omarmustafa130/Custom-ESP-Controller/Zrzut ekranu 2025-04-6 o 13.15.30.png

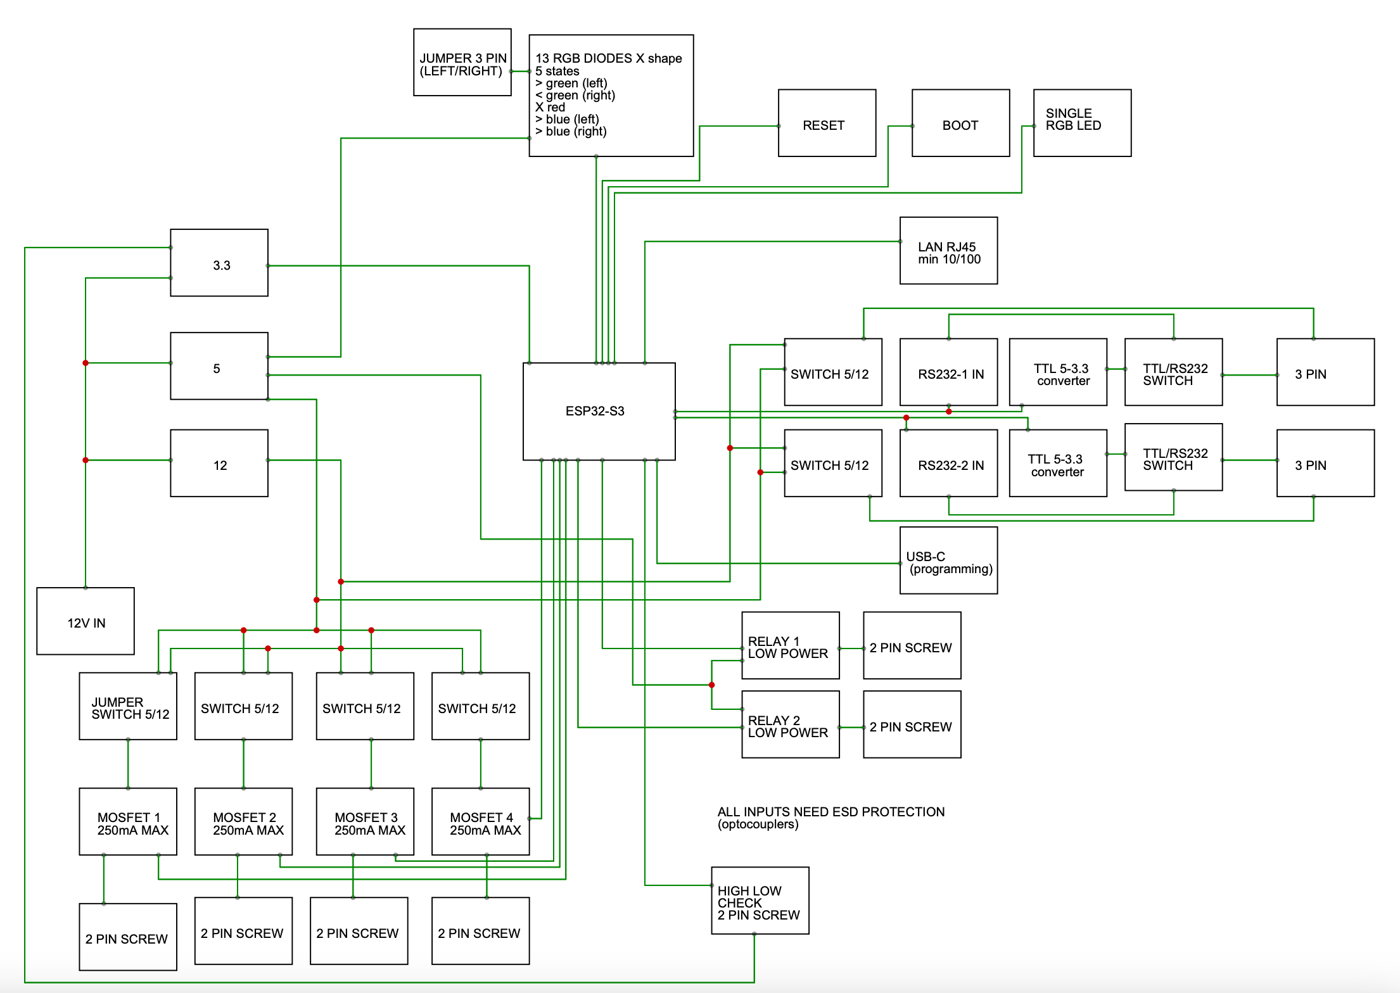
Zrzut ekranu 2025-04-6 o 13.15.30.png
