omarmustafa130/Custom-ESP-Controller/Symbols, footprints, & 3d parts/ETHERNET/LIB_HSO321S/HSO321S/3D/HSO321S.stp

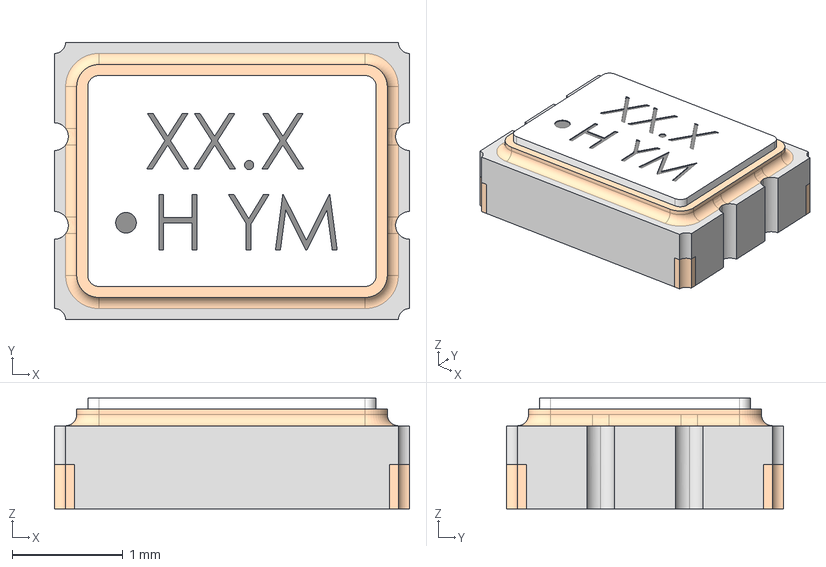
[picture p2: CAD file, 2025-05-19]
Symbols, footprints, & 3d parts/ETHERNET/LIB_HSO321S/HSO321S/3D/HSO321S.stp
3.20 x 2.50 x 1.00 mm
SSW024576F3CHC-T
SSW024576F3CHC-T003
SSW024576F3CHC-T004
SSW024576F3CHC-T002
SSW024576F3CHC-T001
