omarmustafa130/Custom-ESP-Controller/Symbols, footprints, & 3d parts/ETHERNET/LIB_W5500/W5500/3D/W5500.stp

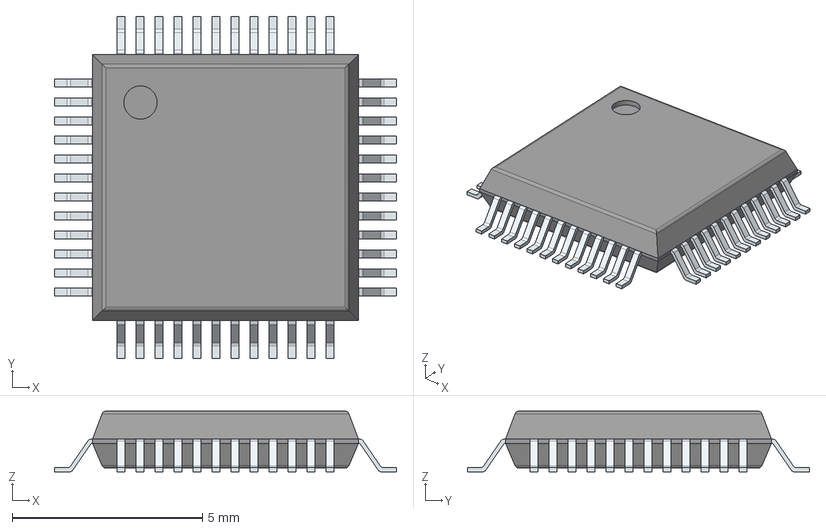
[picture p3: CAD file, 2025-05-19]
Symbols, footprints, & 3d parts/ETHERNET/LIB_W5500/W5500/3D/W5500.stp
9.00 x 9.00 x 1.60 mm
PinsArrayLR
PinsArrayTB
