omarmustafa130/Custom-ESP-Controller/Symbols, footprints, & 3d parts/ETHERNET/RJ45_163141781-659-5-2301994-9/5-2301994-9.stp

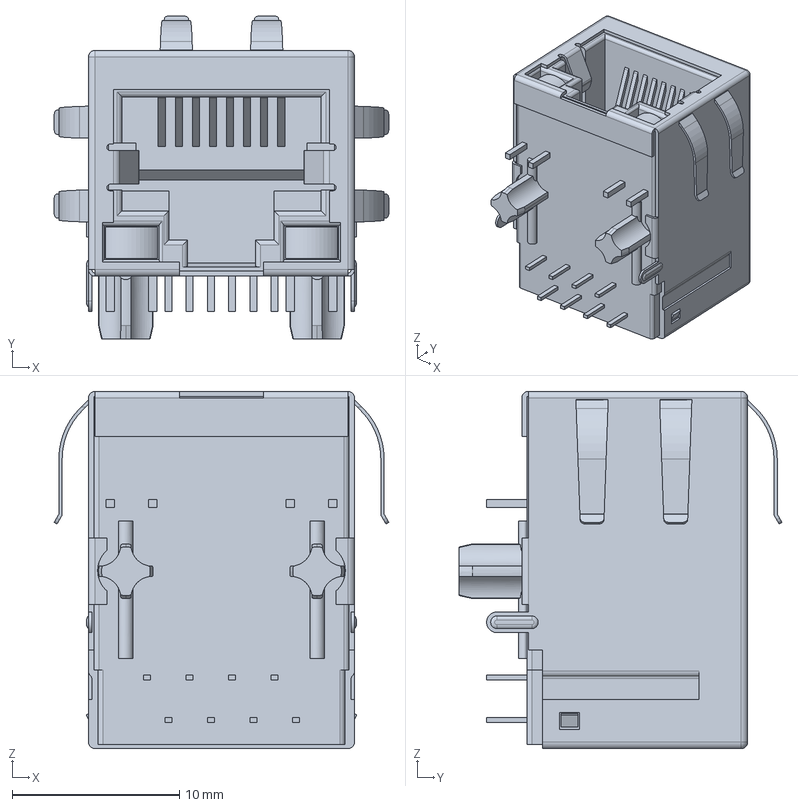
[picture p4: CAD file, 2025-05-19]
Symbols, footprints, & 3d parts/ETHERNET/RJ45_163141781-659-5-2301994-9/5-2301994-9.stp
20.0 x 19.3 x 21.4 mm
