omarmustafa130/Custom-ESP-Controller/Symbols, footprints, & 3d parts/LIB_ECS-3225MVQ-400-BS-TR/ECS-3225MVQ-400-BS-TR/3D/ECS-3225MVQ-400-BS-TR.stp

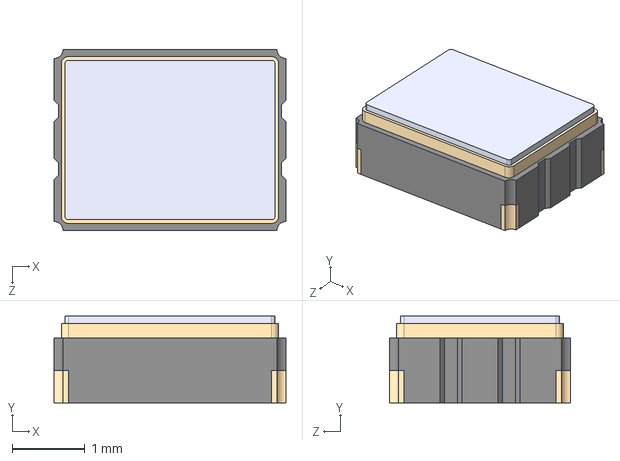
[picture p5: CAD file, 2025-05-18]
Symbols, footprints, & 3d parts/LIB_ECS-3225MVQ-400-BS-TR/ECS-3225MVQ-400-BS-TR/3D/ECS-3225MVQ-400-BS-TR.stp
3.20 x 1.20 x 2.50 mm
