omarmustafa130/Custom-ESP-Controller/Symbols, footprints, & 3d parts/LIB_ESP32-C6/ESP32-C6/3D/ESP32-C6.stp

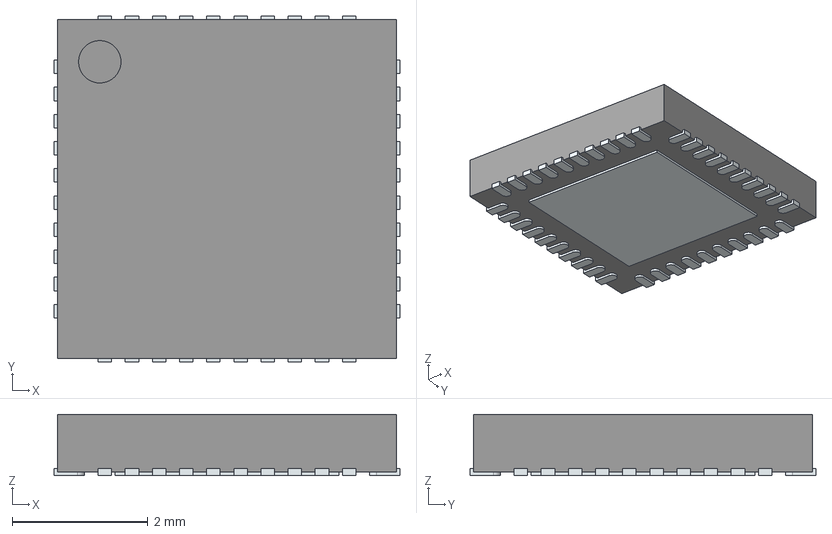
[picture p6: CAD file, 2025-05-18]
Symbols, footprints, & 3d parts/LIB_ESP32-C6/ESP32-C6/3D/ESP32-C6.stp
5.10 x 5.10 x 0.9 mm
ThermalPin
PinsArrayLR
PinsArrayTB
