omarmustafa130/Custom-ESP-Controller/Symbols, footprints, & 3d parts/LIB_ESP32-D0WDQ6/ESP32-D0WDQ6/3D/ESP32-D0WDQ6.stp

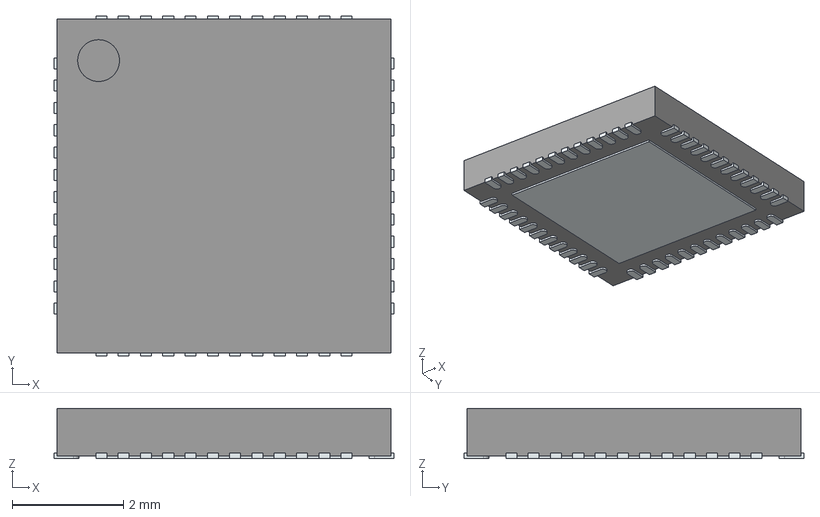
[picture p7: CAD file, 2025-05-18]
Symbols, footprints, & 3d parts/LIB_ESP32-D0WDQ6/ESP32-D0WDQ6/3D/ESP32-D0WDQ6.stp
6.10 x 6.10 x 0.9 mm
ThermalPin
PinsArrayLR
PinsArrayTB
