omarmustafa130/Custom-ESP-Controller/Symbols, footprints, & 3d parts/LIB_ESP32-S3/ESP32-S3/3D/ESP32-S3.stp

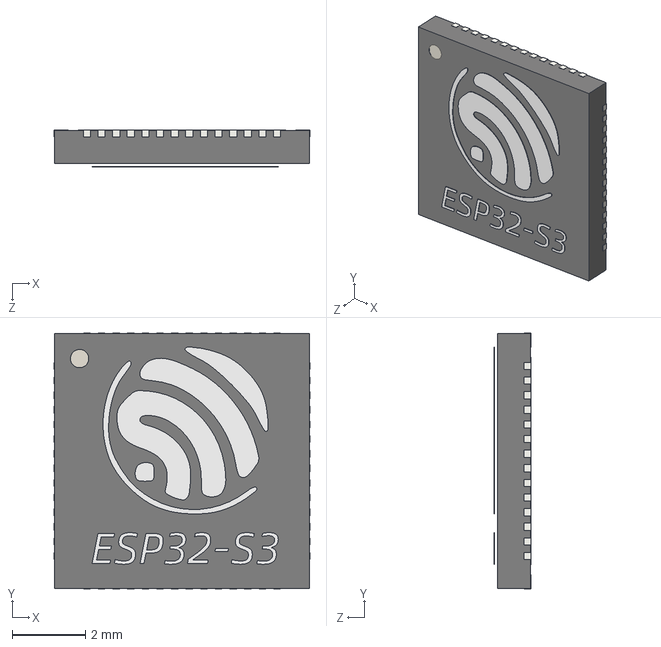
[picture p8: CAD file, 2025-05-18]
Symbols, footprints, & 3d parts/LIB_ESP32-S3/ESP32-S3/3D/ESP32-S3.stp
7.00 x 7.00 x 1.02 mm
