omarmustafa130/Custom-ESP-Controller/Symbols, footprints, & 3d parts/LIB_H1102NLT/H1102NLT/3D/H1102NLT.stp

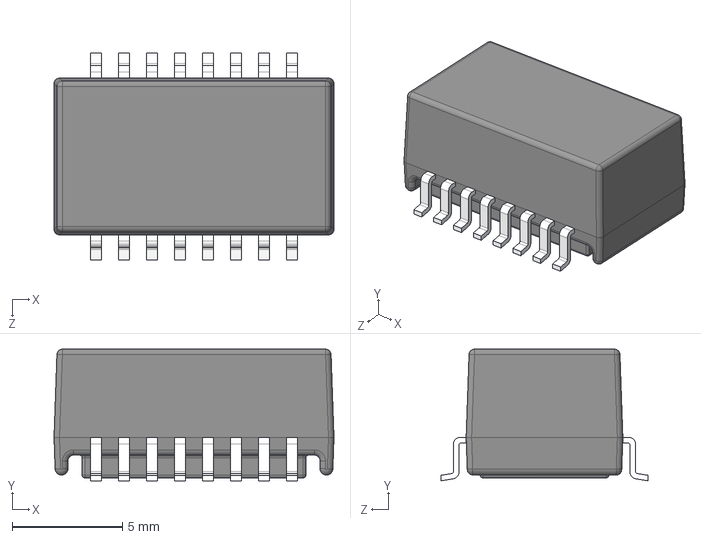
[picture p9: CAD file, 2025-05-18]
Symbols, footprints, & 3d parts/LIB_H1102NLT/H1102NLT/3D/H1102NLT.stp
12.7 x 5.97 x 9.40 mm
