omarmustafa130/Custom-ESP-Controller/Symbols, footprints, & 3d parts/LIB_J1B1211CCD/J1B1211CCD/3D/J1B1211CCD.stp

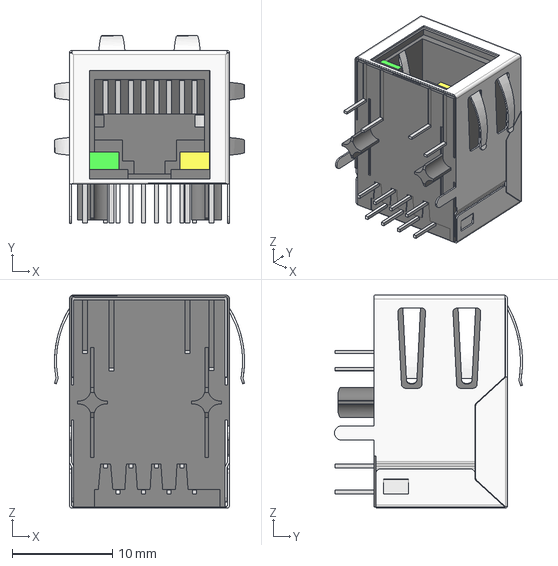
[picture p10: CAD file, 2025-05-18]
Symbols, footprints, & 3d parts/LIB_J1B1211CCD/J1B1211CCD/3D/J1B1211CCD.stp
19.0 x 18.8 x 21.3 mm
