omarmustafa130/Custom-ESP-Controller/Symbols, footprints, & 3d parts/MOSFETS/LIB_IRLML6244TRPBF/IRLML6244TRPBF/3D/IRLML6244TRPBF.stp

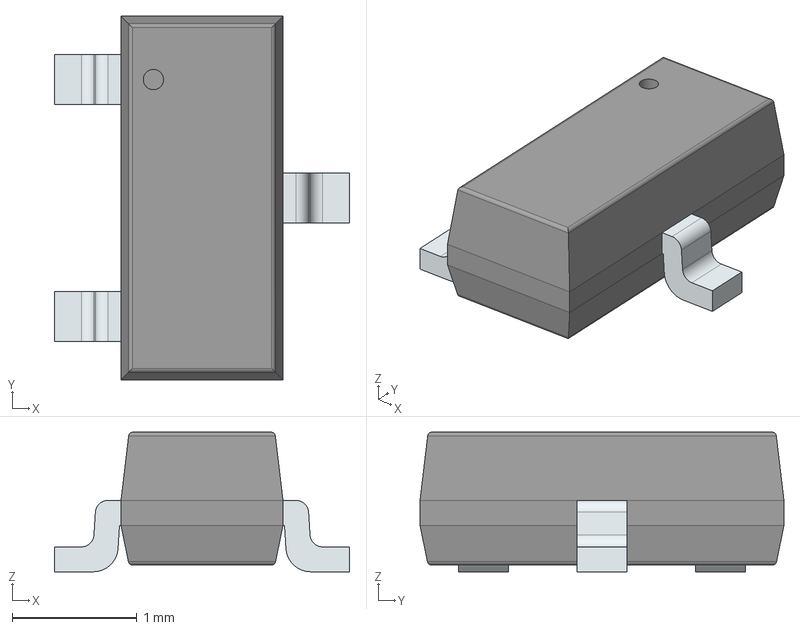
[picture p11: CAD file, 2025-05-19]
Symbols, footprints, & 3d parts/MOSFETS/LIB_IRLML6244TRPBF/IRLML6244TRPBF/3D/IRLML6244TRPBF.stp
2.37 x 2.92 x 1.12 mm
PinsArrayL
FilletPinR
