omarmustafa130/Custom-ESP-Controller/Symbols, footprints, & 3d parts/Power Circuit/LIB_1N5822/1N5822/3D/1N5822.stp

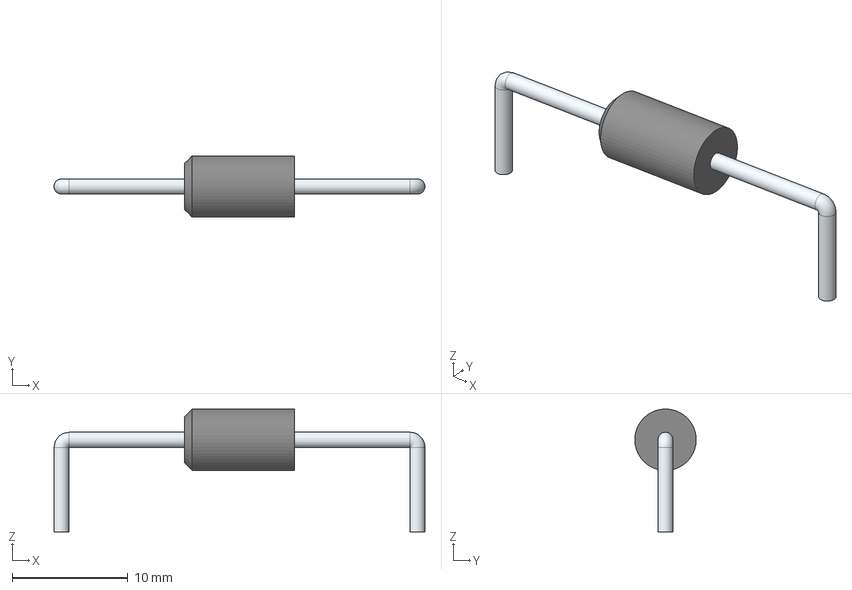
[picture p12: CAD file, 2025-05-19]
Symbols, footprints, & 3d parts/Power Circuit/LIB_1N5822/1N5822/3D/1N5822.stp
32.0 x 5.30 x 10.6 mm
