omarmustafa130/Custom-ESP-Controller/Symbols, footprints, & 3d parts/Power Circuit/LIB_SMAJ58A/SMAJ58A/3D/SMAJ58A.stp

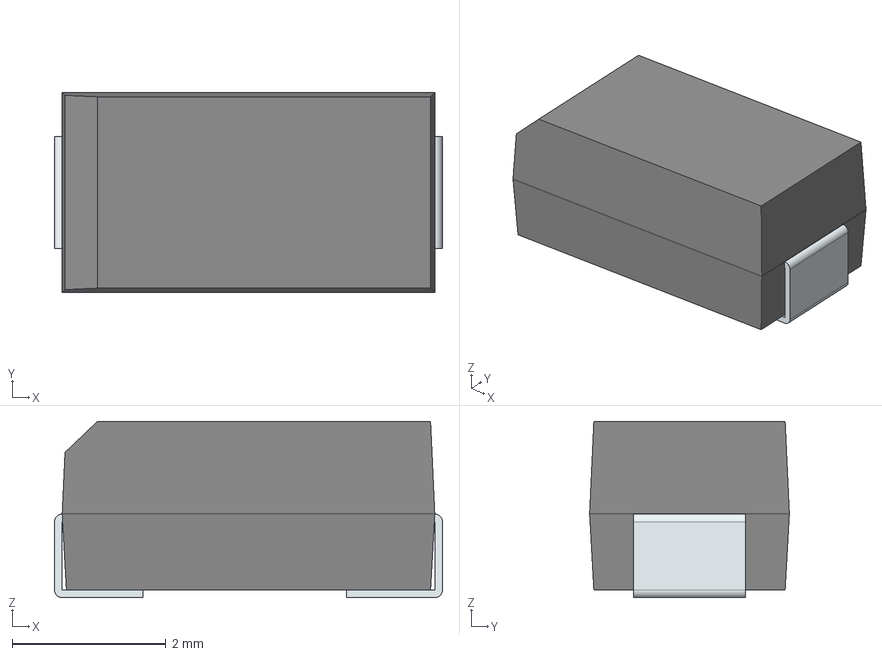
[picture p13: CAD file, 2025-05-19]
Symbols, footprints, & 3d parts/Power Circuit/LIB_SMAJ58A/SMAJ58A/3D/SMAJ58A.stp
5.04 x 2.60 x 2.29 mm
FilletPin1
FilletPin2
