omarmustafa130/Custom-ESP-Controller/Symbols, footprints, & 3d parts/Power Circuit/LIB_SMD_IC_SY8089AAAC/SMD_IC_SY8089AAAC/3D/SMD_IC_SY8089AAAC.stp

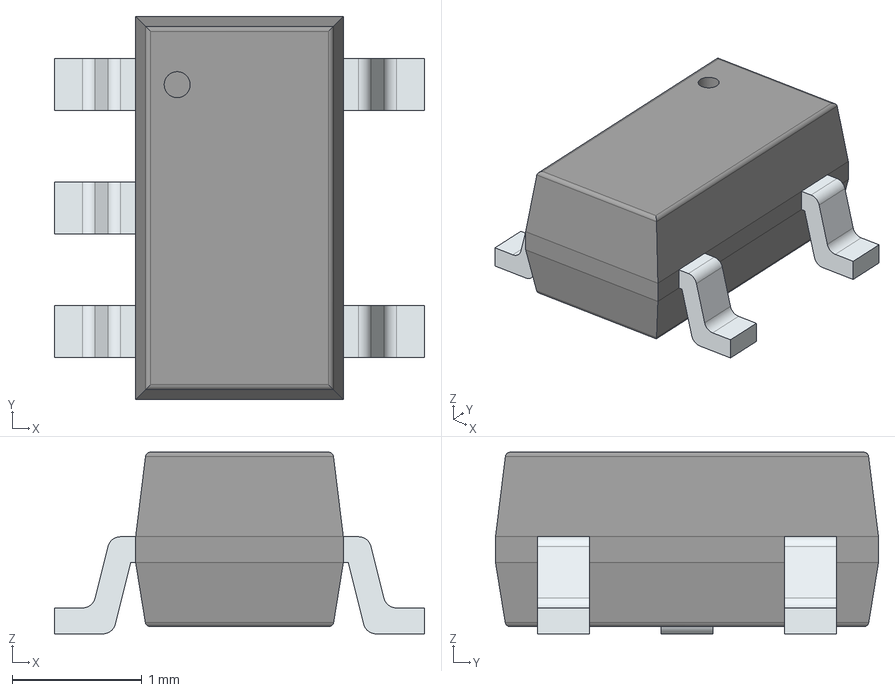
[picture p14: CAD file, 2025-05-18]
Symbols, footprints, & 3d parts/Power Circuit/LIB_SMD_IC_SY8089AAAC/SMD_IC_SY8089AAAC/3D/SMD_IC_SY8089AAAC.stp
2.85 x 2.95 x 1.40 mm
PinsArrayL
PinsArrayR
