omarmustafa130/Custom-ESP-Controller/Symbols, footprints, & 3d parts/Power Circuit/LIB_TX4138/TX4138/3D/TX4138.stp

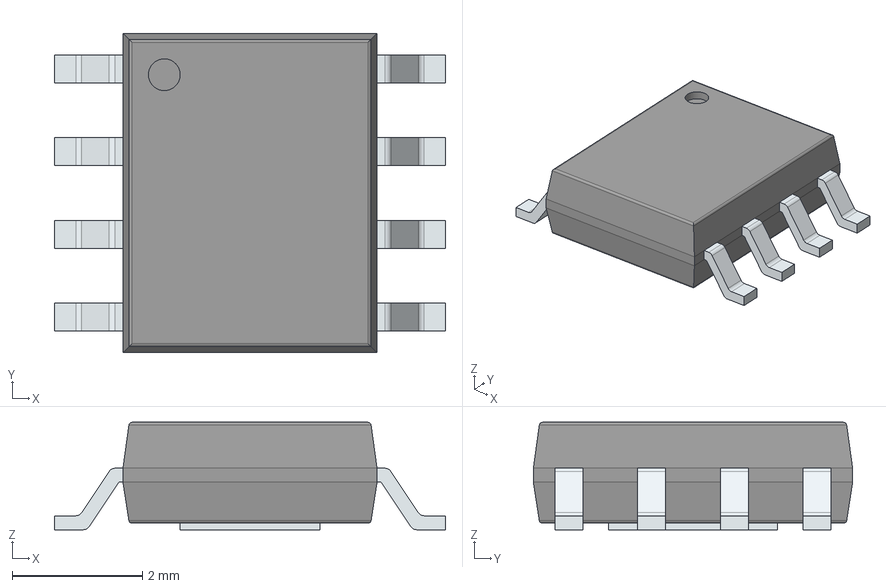
[picture p15: CAD file, 2025-05-19]
Symbols, footprints, & 3d parts/Power Circuit/LIB_TX4138/TX4138/3D/TX4138.stp
6.00 x 4.90 x 1.65 mm
PinsArrayLR
ThermalPad
