omarmustafa130/Custom-ESP-Controller/Symbols, footprints, & 3d parts/Power Circuit/NR3015T2R2M/NR3015T2R2M.step

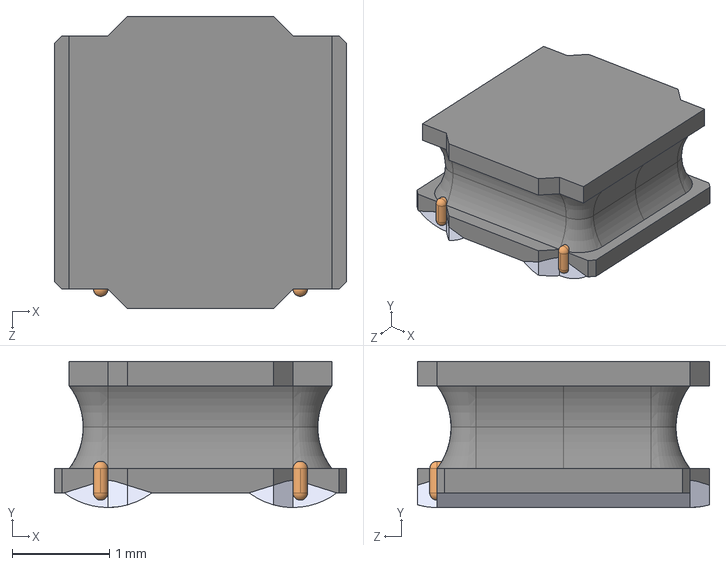
[picture p16: CAD file, 2025-05-19]
Symbols, footprints, & 3d parts/Power Circuit/NR3015T2R2M/NR3015T2R2M.step
3.00 x 1.50 x 3.00 mm
