omarmustafa130/Custom-ESP-Controller/Symbols, footprints, & 3d parts/Power Circuit/SS310/SS310.step

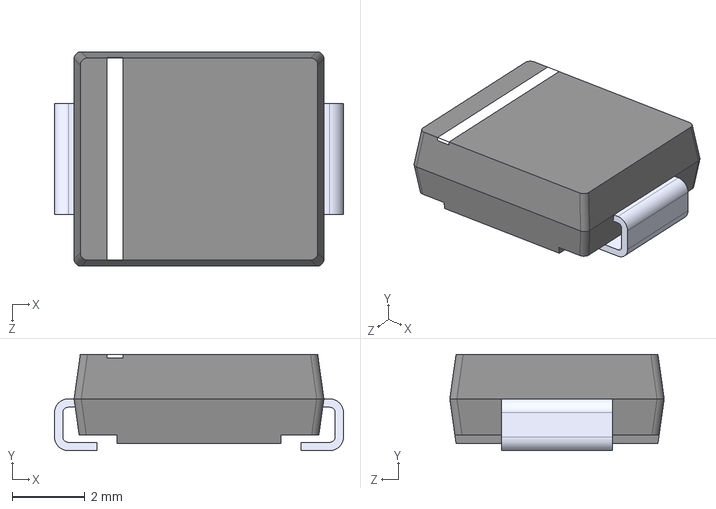
[picture p17: CAD file, 2025-05-19]
Symbols, footprints, & 3d parts/Power Circuit/SS310/SS310.step
7.95 x 2.65 x 5.90 mm
