omarmustafa130/Custom-ESP-Controller/Symbols, footprints, & 3d parts/RELAYS/LIB_1N4148W/1N4148W/3D/1N4148W.stp

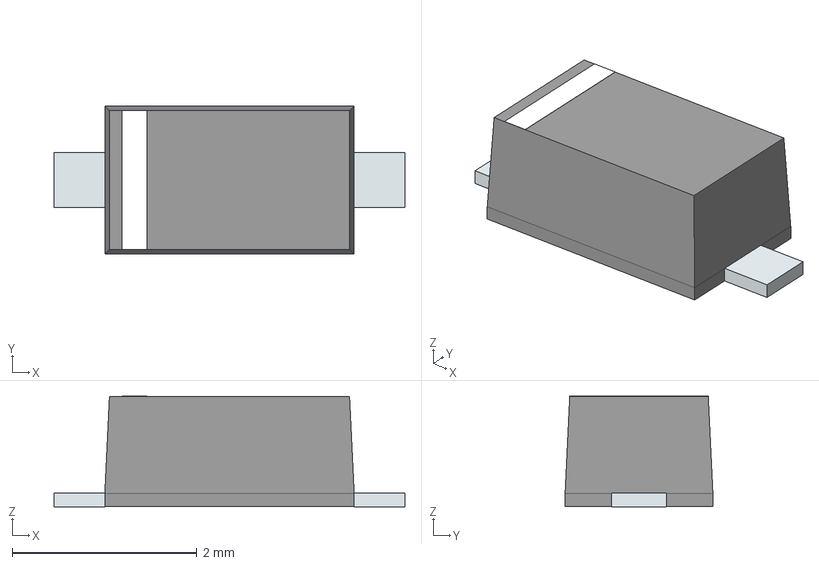
[picture p18: CAD file, 2025-05-19]
Symbols, footprints, & 3d parts/RELAYS/LIB_1N4148W/1N4148W/3D/1N4148W.stp
3.80 x 1.60 x 1.20 mm
PinKIdent
PinK
PinA
