omarmustafa130/Custom-ESP-Controller/Symbols, footprints, & 3d parts/RELAYS/LIB_LMUN2235LT1G/LMUN2235LT1G/3D/LMUN2235LT1G.stp

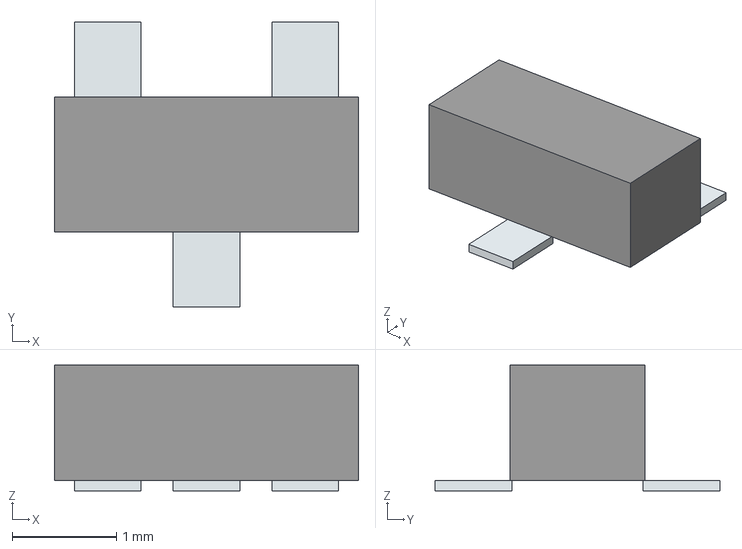
[picture p19: CAD file, 2025-05-19]
Symbols, footprints, & 3d parts/RELAYS/LIB_LMUN2235LT1G/LMUN2235LT1G/3D/LMUN2235LT1G.stp
2.92 x 2.74 x 1.21 mm
Pins
