omarmustafa130/Custom-ESP-Controller/Symbols, footprints, & 3d parts/RELAYS/SRD-05VDC-SL-C/SRD-05VDC-SL-C.step

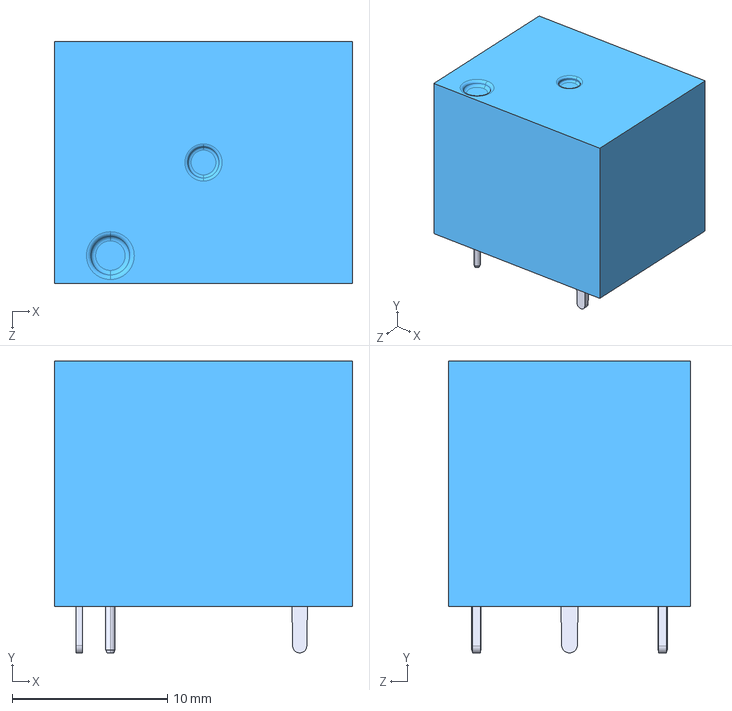
[picture p20: CAD file, 2025-05-19]
Symbols, footprints, & 3d parts/RELAYS/SRD-05VDC-SL-C/SRD-05VDC-SL-C.step
19.2 x 18.8 x 15.6 mm
