omarmustafa130/Custom-ESP-Controller/Symbols, footprints, & 3d parts/RS232/LIB_MAX3232EIDR/MAX3232EIDR/3D/MAX3232EIDR.stp

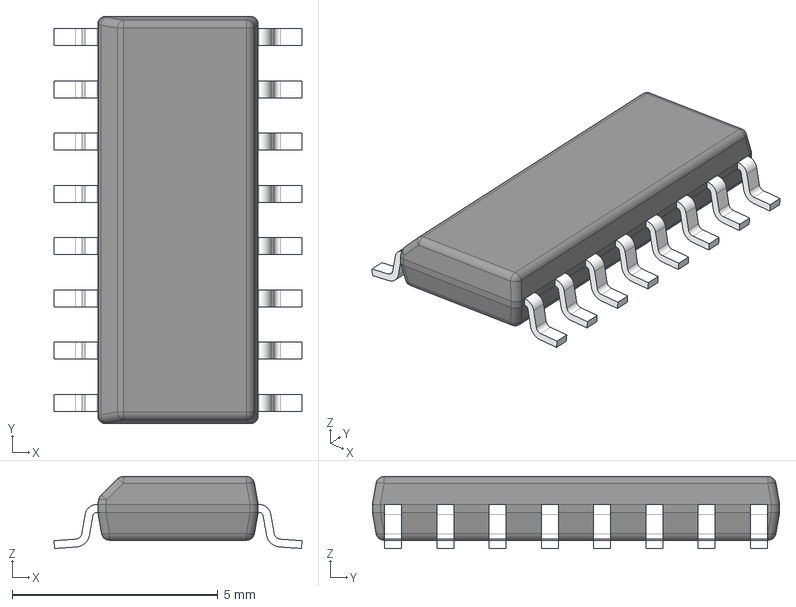
[picture p21: CAD file, 2025-05-18]
Symbols, footprints, & 3d parts/RS232/LIB_MAX3232EIDR/MAX3232EIDR/3D/MAX3232EIDR.stp
6.03 x 9.90 x 1.75 mm
BODY-SO
LEAD-SO x 16
PIN1-ID
