omarmustafa130/Custom-ESP-Controller/Symbols, footprints, & 3d parts/USB_TTL/LIB_CP2102N-A01-GQFN28/CP2102N-A01-GQFN28/3D/CP2102N-A01-GQFN28.stp

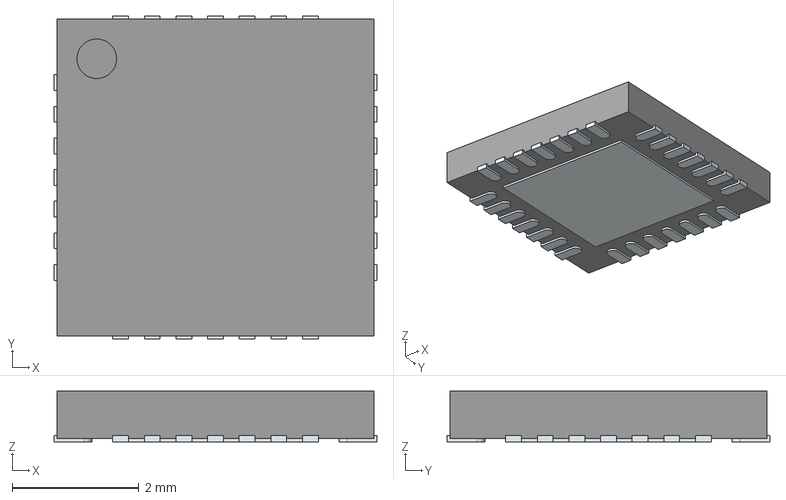
[picture p22: CAD file, 2025-05-19]
Symbols, footprints, & 3d parts/USB_TTL/LIB_CP2102N-A01-GQFN28/CP2102N-A01-GQFN28/3D/CP2102N-A01-GQFN28.stp
5.10 x 5.10 x 0.8 mm
ThermalPin
PinsArrayLR
PinsArrayTB
