omarmustafa130/Custom-ESP-Controller/(list of files, cad)

Other CAD files:
Symbols, footprints, & 3d parts/USB_TTL/LIB_SS8050-G/SS8050-G/3D/SS8050-G.stp
Symbols, footprints, & 3d parts/ESP32/LIB_ESP32-C6-WROOM-1-N4/ESP32-C6-WROOM-1-N4/Allegro/esp32c6wroom1n4.psm
Symbols, footprints, & 3d parts/ESP32/LIB_ESP32-C6-WROOM-1-N4/ESP32-C6-WROOM-1-N4/DEHDL/esp32_c6_wroom_1_n4/chips/chips.prt
Symbols, footprints, & 3d parts/ETHERNET/LIB_HSO321S/HSO321S/Allegro/hso321s.psm
Symbols, footprints, & 3d parts/ETHERNET/LIB_HSO321S/HSO321S/DEHDL/hso321s/chips/chips.prt
Symbols, footprints, & 3d parts/ETHERNET/LIB_W5500/W5500/Allegro/qfp50p900x900x160-48n.psm
Symbols, footprints, & 3d parts/ETHERNET/LIB_W5500/W5500/DEHDL/w5500/chips/chips.prt
Symbols, footprints, & 3d parts/LIB_ECS-3225MVQ-400-BS-TR/ECS-3225MVQ-400-BS-TR/Allegro/ecs3225mvq400bstr.psm
Symbols, footprints, & 3d parts/LIB_ECS-3225MVQ-400-BS-TR/ECS-3225MVQ-400-BS-TR/DEHDL/ecs_3225mvq_400_bs_tr/chips/chips.prt
Symbols, footprints, & 3d parts/LIB_ESP32-C6/ESP32-C6/Allegro/qfn40p500x500x90-41n-d.psm
Symbols, footprints, & 3d parts/LIB_ESP32-C6/ESP32-C6/DEHDL/esp32_c6/chips/chips.prt
Symbols, footprints, & 3d parts/LIB_ESP32-D0WDQ6/ESP32-D0WDQ6/Allegro/qfn40p600x600x90-49n-d.psm
Symbols, footprints, & 3d parts/LIB_ESP32-D0WDQ6/ESP32-D0WDQ6/DEHDL/esp32_d0wdq6/chips/chips.prt
Symbols, footprints, & 3d parts/LIB_ESP32-S3/ESP32-S3/Allegro/qfn40p700x700x90-57n-d.psm
Symbols, footprints, & 3d parts/LIB_ESP32-S3/ESP32-S3/DEHDL/esp32_s3/chips/chips.prt
Symbols, footprints, & 3d parts/LIB_H1102NLT/H1102NLT/Allegro/soic127p940x622-16n.psm
Symbols, footprints, & 3d parts/LIB_H1102NLT/H1102NLT/DEHDL/h1102nlt/chips/chips.prt
Symbols, footprints, & 3d parts/LIB_J1B1211CCD/J1B1211CCD/Allegro/j1b1211ccd.psm
Symbols, footprints, & 3d parts/LIB_J1B1211CCD/J1B1211CCD/DEHDL/j1b1211ccd/chips/chips.prt
Symbols, footprints, & 3d parts/MOSFETS/LIB_IRLML6244TRPBF/IRLML6244TRPBF/Allegro/sot95p237x112-3n.psm
Symbols, footprints, & 3d parts/MOSFETS/LIB_IRLML6244TRPBF/IRLML6244TRPBF/DEHDL/irlml6244trpbf/chips/chips.prt
Symbols, footprints, & 3d parts/Power Circuit/LIB_1N5822/1N5822/Allegro/dioad3070w130l950d530.psm
Symbols, footprints, & 3d parts/Power Circuit/LIB_1N5822/1N5822/DEHDL/1n5822/chips/chips.prt
Symbols, footprints, & 3d parts/Power Circuit/LIB_694106301002/694106301002/3D/694106301002.stp
Symbols, footprints, & 3d parts/Power Circuit/LIB_694106301002/694106301002/Allegro/694106301002_1.psm
Symbols, footprints, & 3d parts/Power Circuit/LIB_694106301002/694106301002/DEHDL/694106301002/chips/chips.prt
Symbols, footprints, & 3d parts/Power Circuit/LIB_SMAJ58A/SMAJ58A/Allegro/diom5026x229n.psm
Symbols, footprints, & 3d parts/Power Circuit/LIB_SMAJ58A/SMAJ58A/DEHDL/smaj58a/chips/chips.prt
Symbols, footprints, & 3d parts/Power Circuit/LIB_SMD_IC_SY8089AAAC/SMD_IC_SY8089AAAC/Allegro/sot95p285x140-5n.psm
Symbols, footprints, & 3d parts/Power Circuit/LIB_SMD_IC_SY8089AAAC/SMD_IC_SY8089AAAC/DEHDL/smd_ic_sy8089aaac/chips/chips.prt
Symbols, footprints, & 3d parts/Power Circuit/LIB_TX4138/TX4138/Allegro/soic127p600x165-9n.psm
Symbols, footprints, & 3d parts/Power Circuit/LIB_TX4138/TX4138/DEHDL/tx4138/chips/chips.prt
Symbols, footprints, & 3d parts/Power Circuit/LIB_WPM2015-3_TR/WPM2015-3_TR/Allegro/sot95p240x130-3n.psm
Symbols, footprints, & 3d parts/Power Circuit/LIB_WPM2015-3_TR/WPM2015-3_TR/DEHDL/wpm2015_3_tr/chips/chips.prt
Symbols, footprints, & 3d parts/Power Circuit/ScrewTerminal_691213510002+(rev1)/Download_STP_691213510002+%28rev1%29.stp
Symbols, footprints, & 3d parts/RELAYS/LIB_1N4148W/1N4148W/Allegro/sodfl3816x120n.psm
Symbols, footprints, & 3d parts/RELAYS/LIB_1N4148W/1N4148W/DEHDL/1n4148w/chips/chips.prt
Symbols, footprints, & 3d parts/RELAYS/LIB_LMUN2235LT1G/LMUN2235LT1G/Allegro/lmun2235lt1g.psm
Symbols, footprints, & 3d parts/RELAYS/LIB_LMUN2235LT1G/LMUN2235LT1G/DEHDL/lmun2235lt1g/chips/chips.prt
Symbols, footprints, & 3d parts/RS232/LIB_MAX3232EIDR/MAX3232EIDR/Allegro/soic127p600x175-16n.psm
Symbols, footprints, & 3d parts/RS232/LIB_MAX3232EIDR/MAX3232EIDR/DEHDL/max3232eidr/chips/chips.prt
Symbols, footprints, & 3d parts/USB_TTL/LIB_CP2102N-A01-GQFN28/CP2102N-A01-GQFN28/Allegro/qfn50p500x500x80-29n-d.psm
Symbols, footprints, & 3d parts/USB_TTL/LIB_CP2102N-A01-GQFN28/CP2102N-A01-GQFN28/DEHDL/cp2102n_a01_gqfn28/chips/chips.prt
Symbols, footprints, & 3d parts/USB_TTL/LIB_SS8050-G/SS8050-G/Allegro/sot95p240x115-3n.psm
Symbols, footprints, & 3d parts/USB_TTL/LIB_SS8050-G/SS8050-G/DEHDL/ss8050_g/chips/chips.prt
