omarmustafa130/Custom-ESP-Controller/schematics.pdf

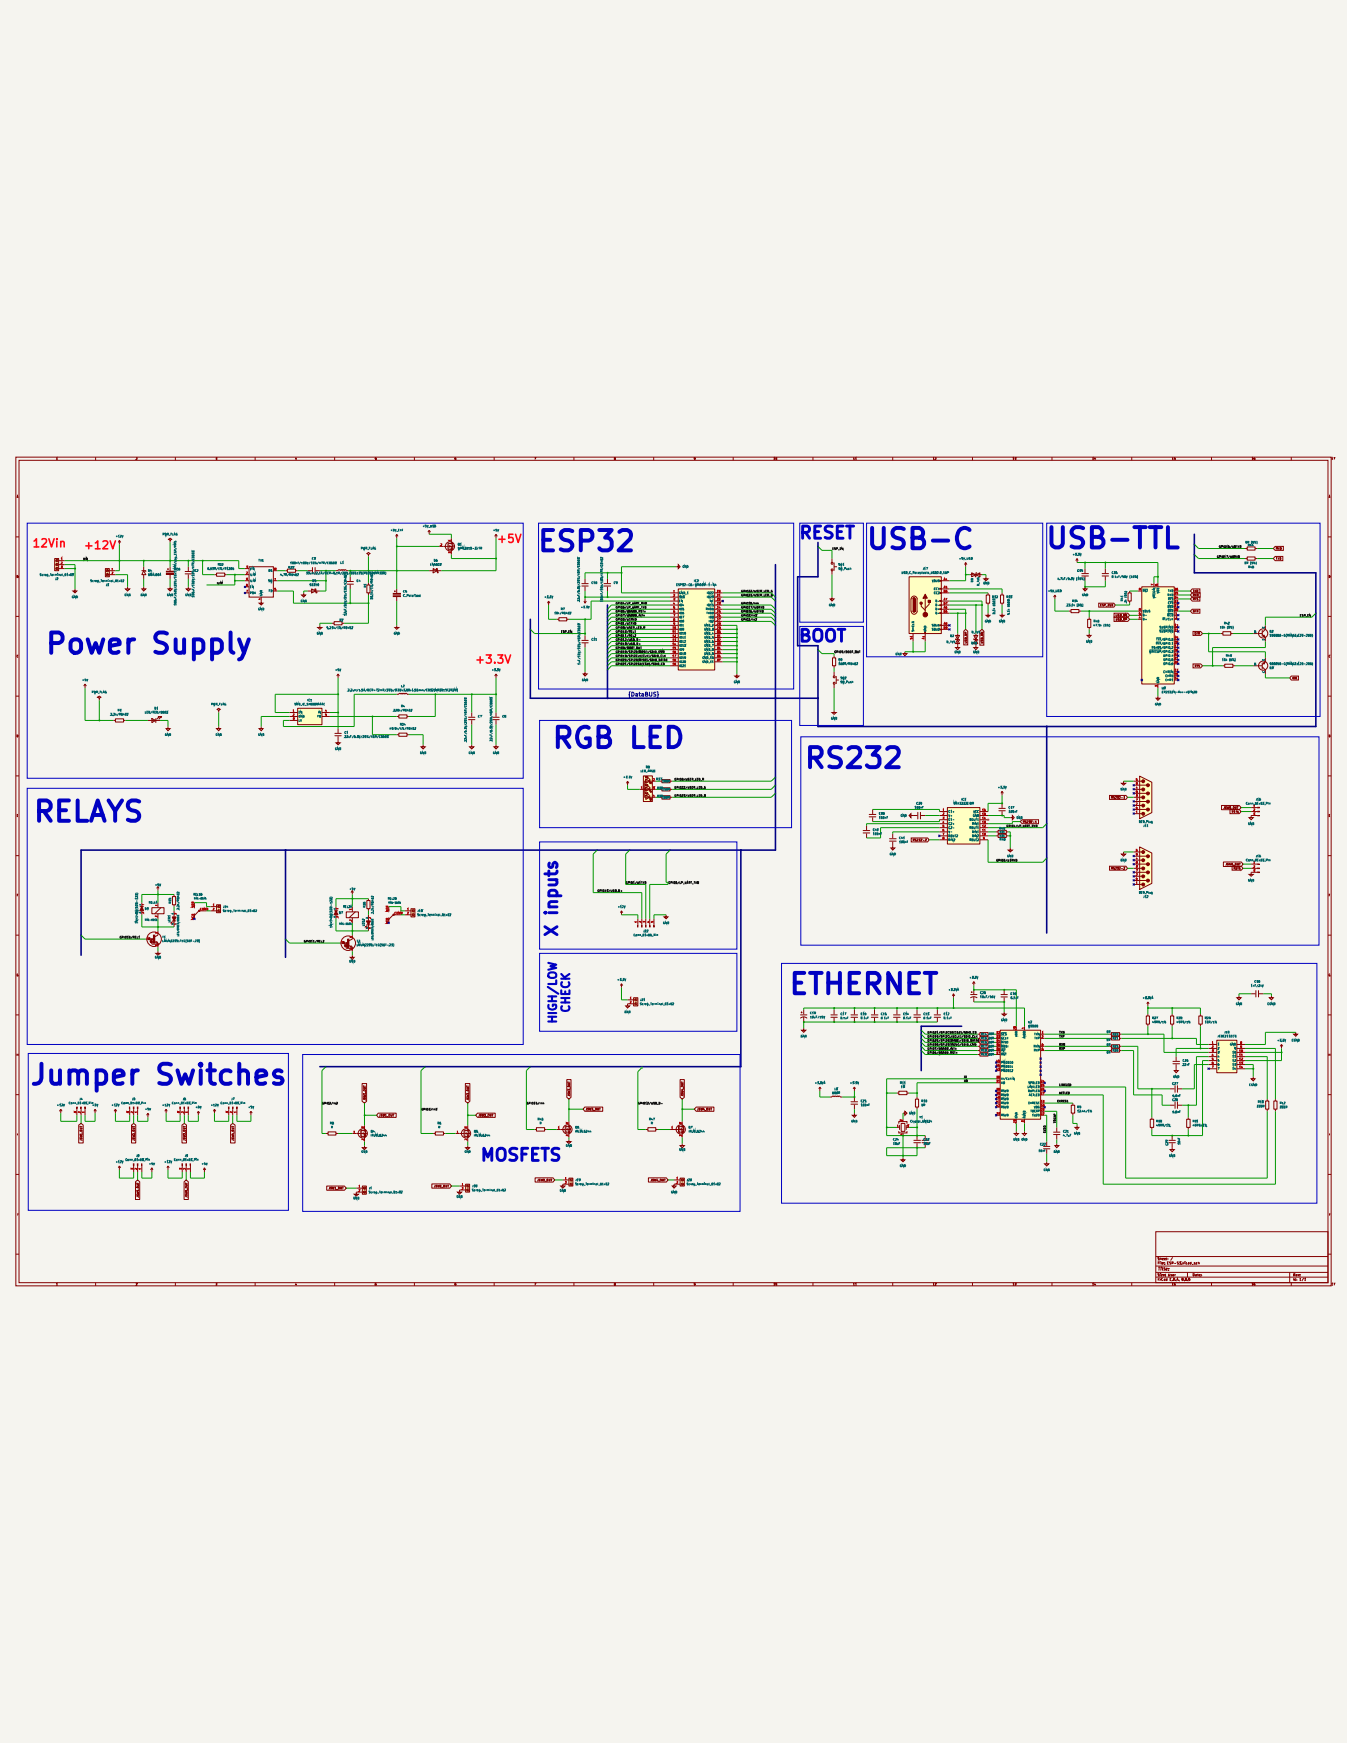
[picture p23: page 1]
