omarmustafa130/Custom-ESP-Controller/Symbols, footprints, & 3d parts/RS232/C183530.pdf

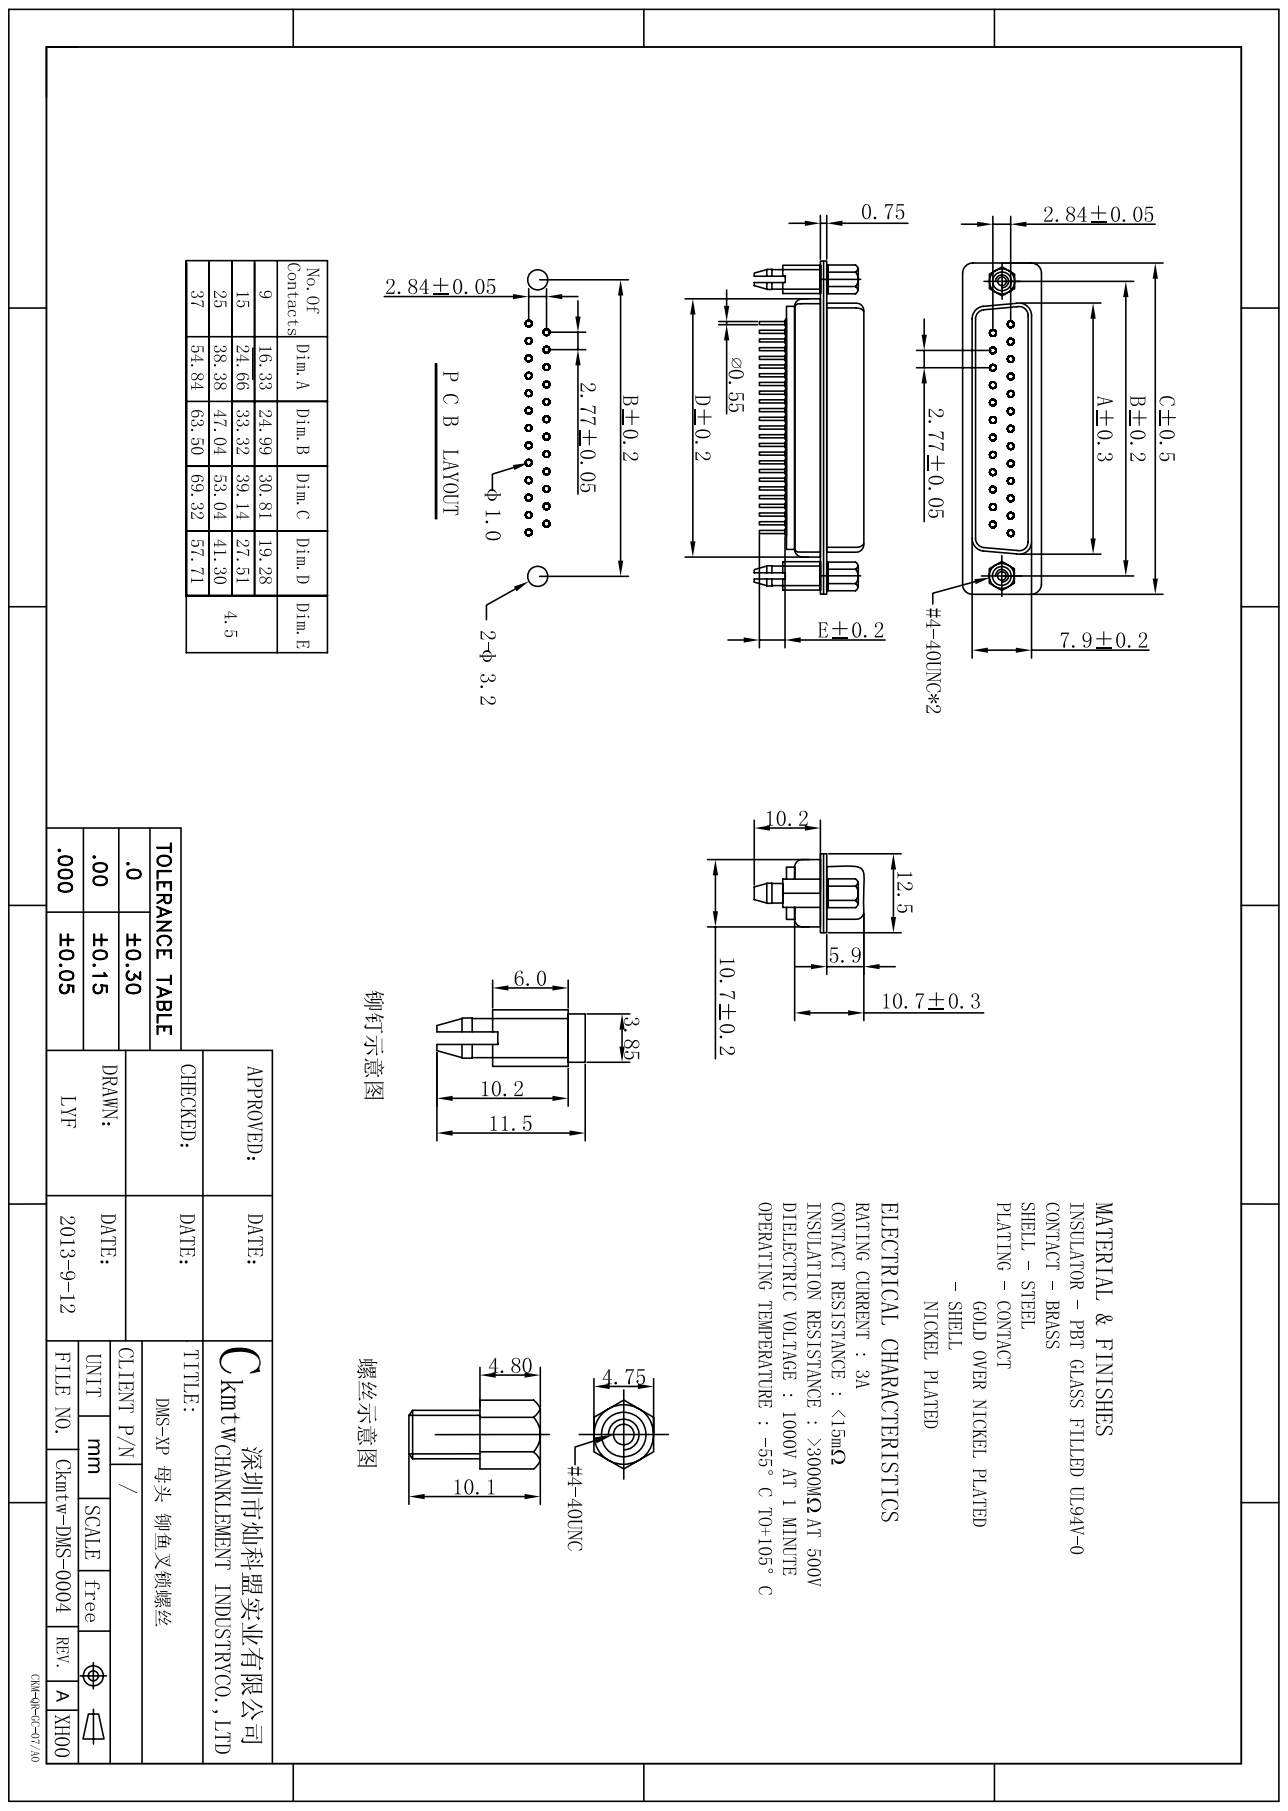
[picture p24: page 1]
