omarmustafa130/Custom-ESP-Controller/Custom ESP Controller/CustmESPController/CustmESPController.kicad_pcb

## KiCad design Custom ESP Controller/CustmESPController/CustmESPController.kicad_pcb (2025-05-19)

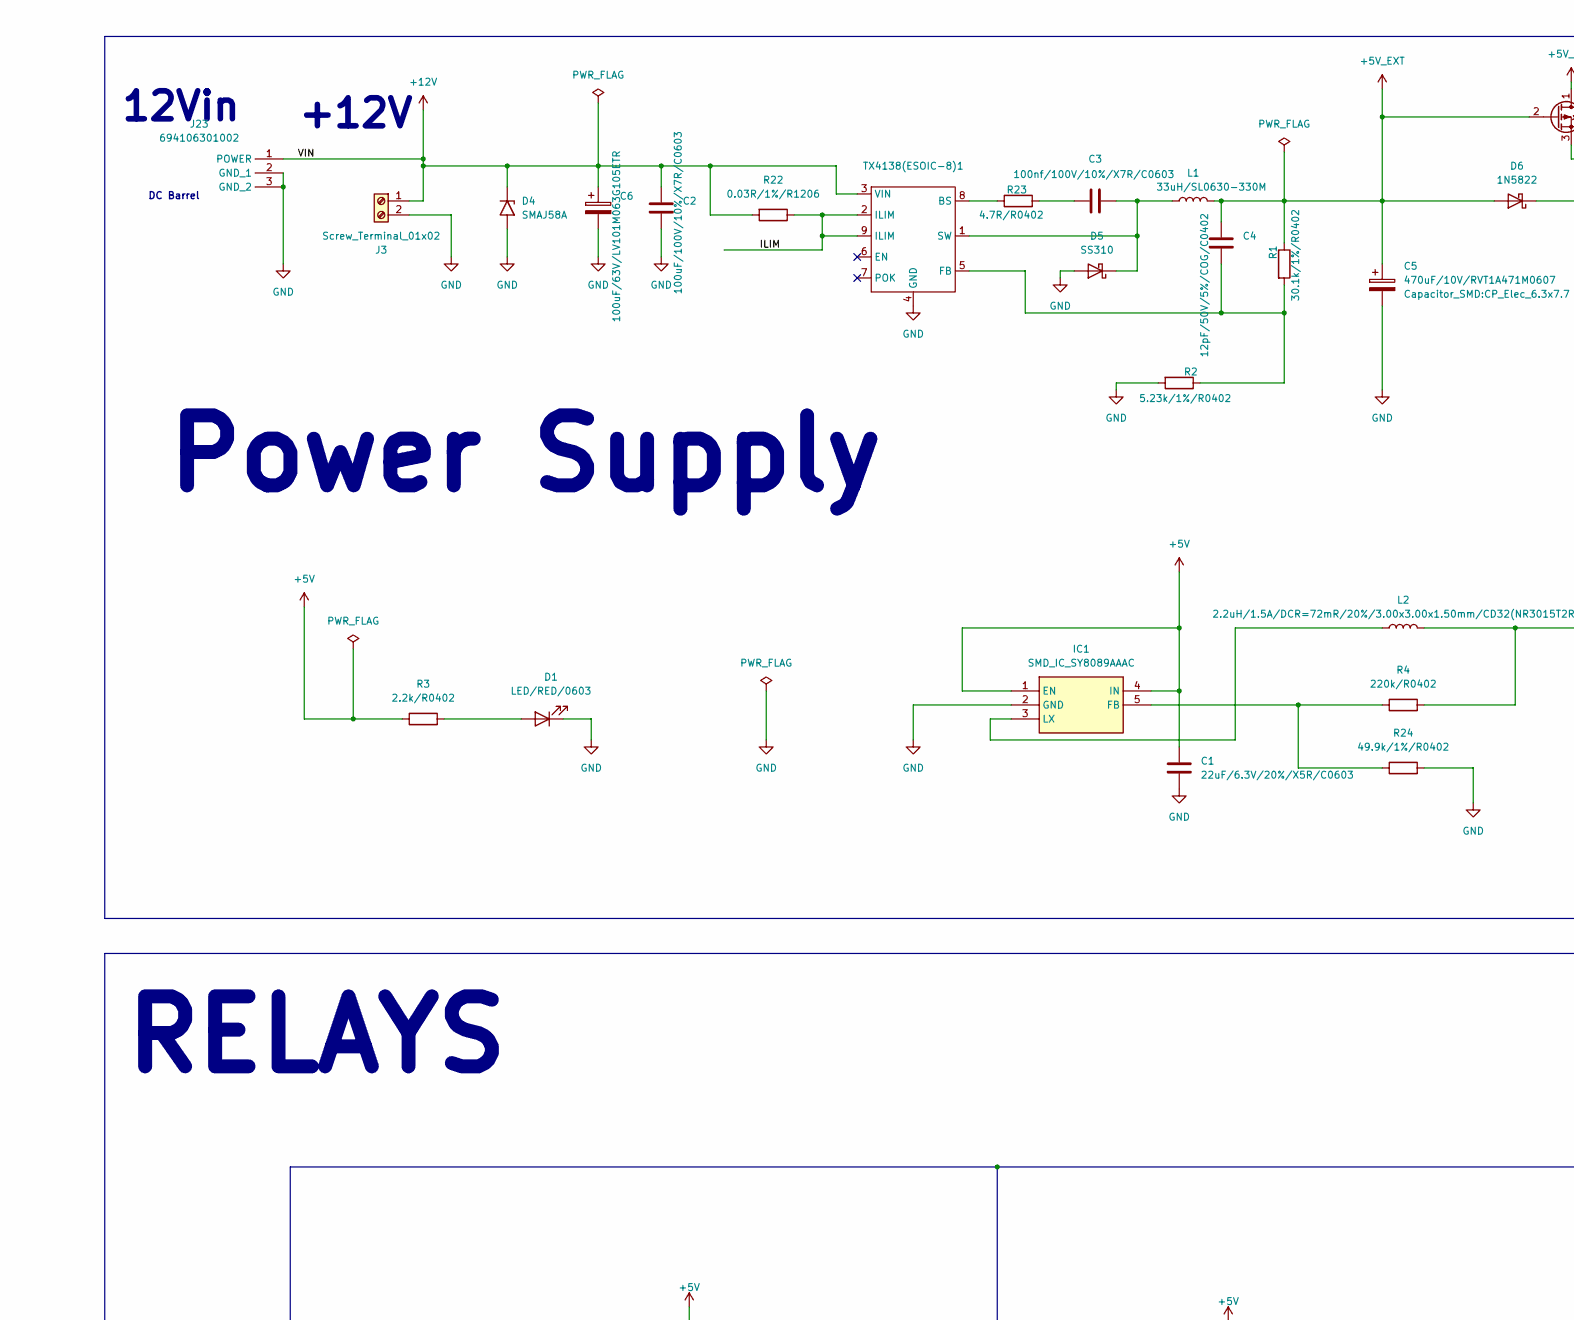
[picture p25: schematic CustmESPController.kicad_sch, part in row 1, column 1]

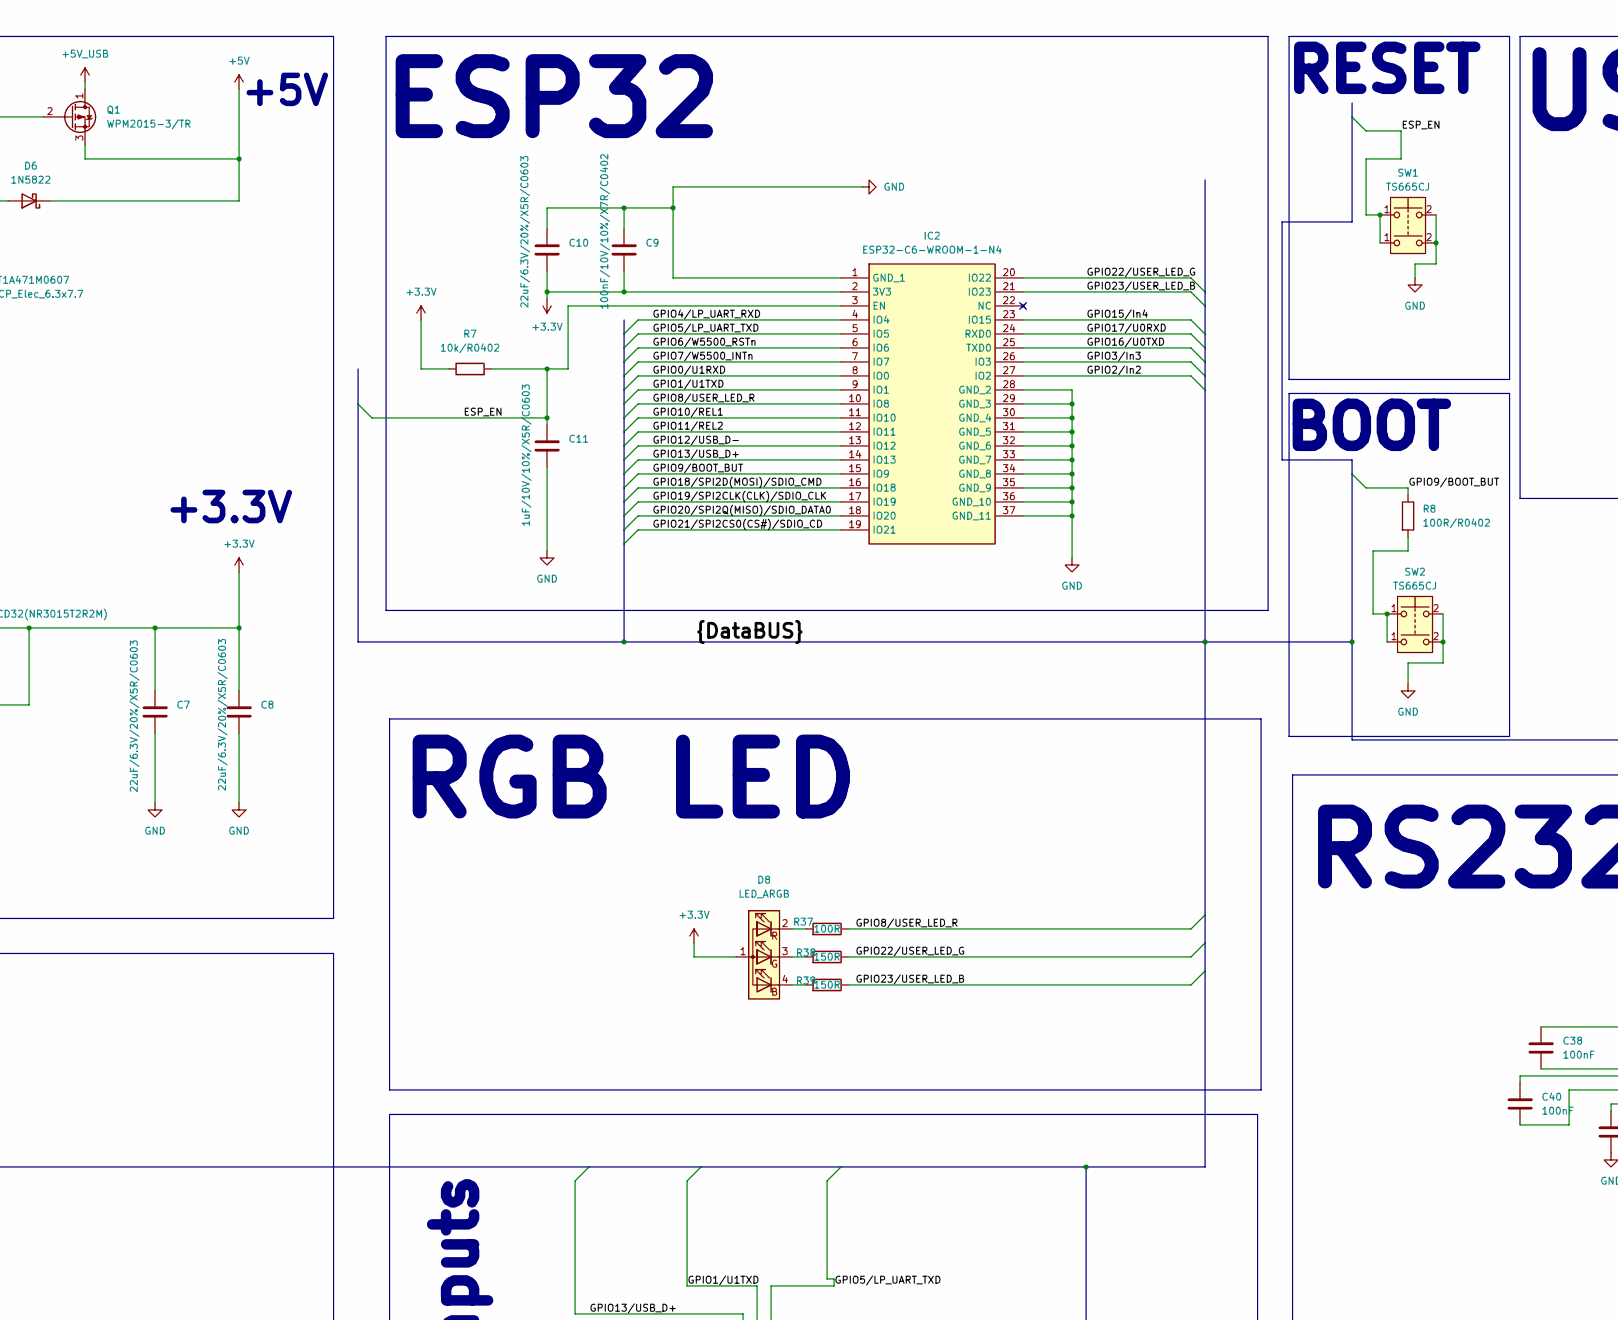
[picture p26: schematic CustmESPController.kicad_sch, part in row 1, column 2]

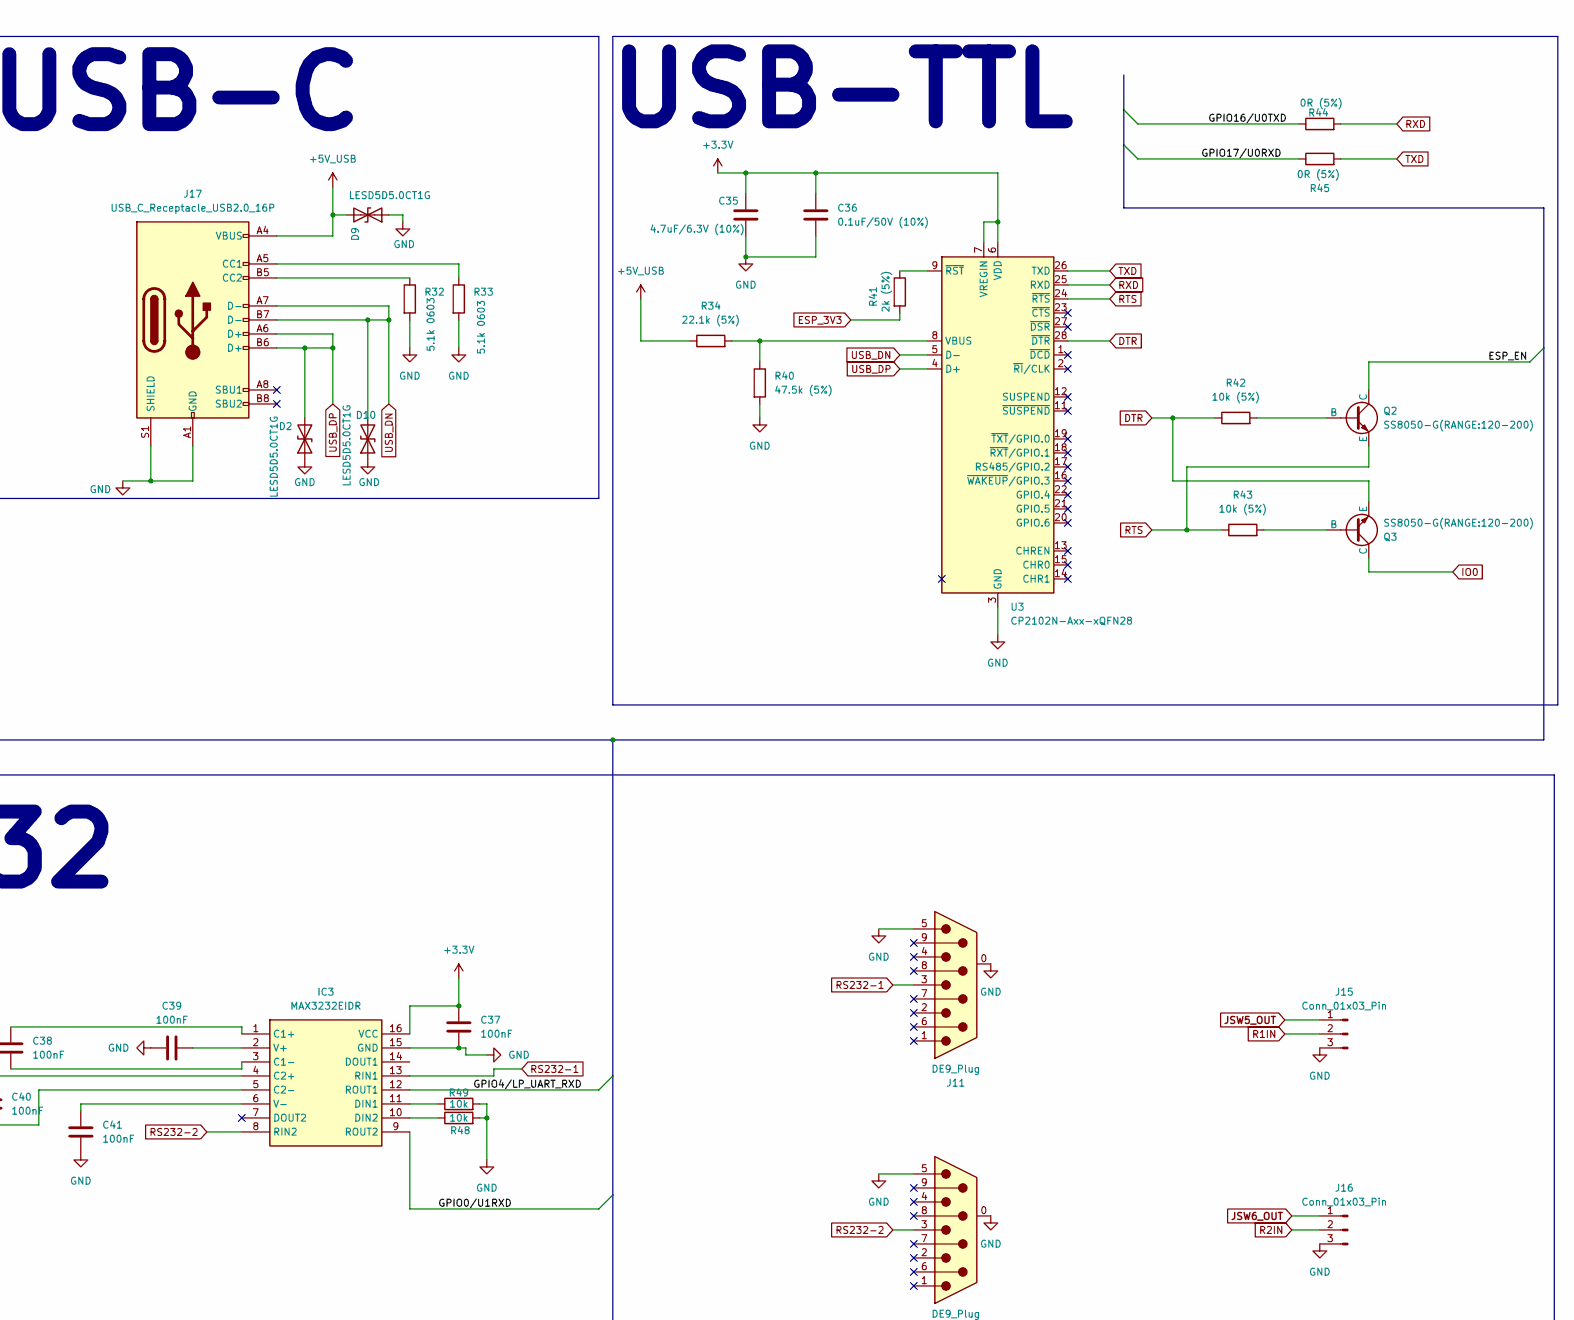
[picture p27: schematic CustmESPController.kicad_sch, part in row 1, column 3]

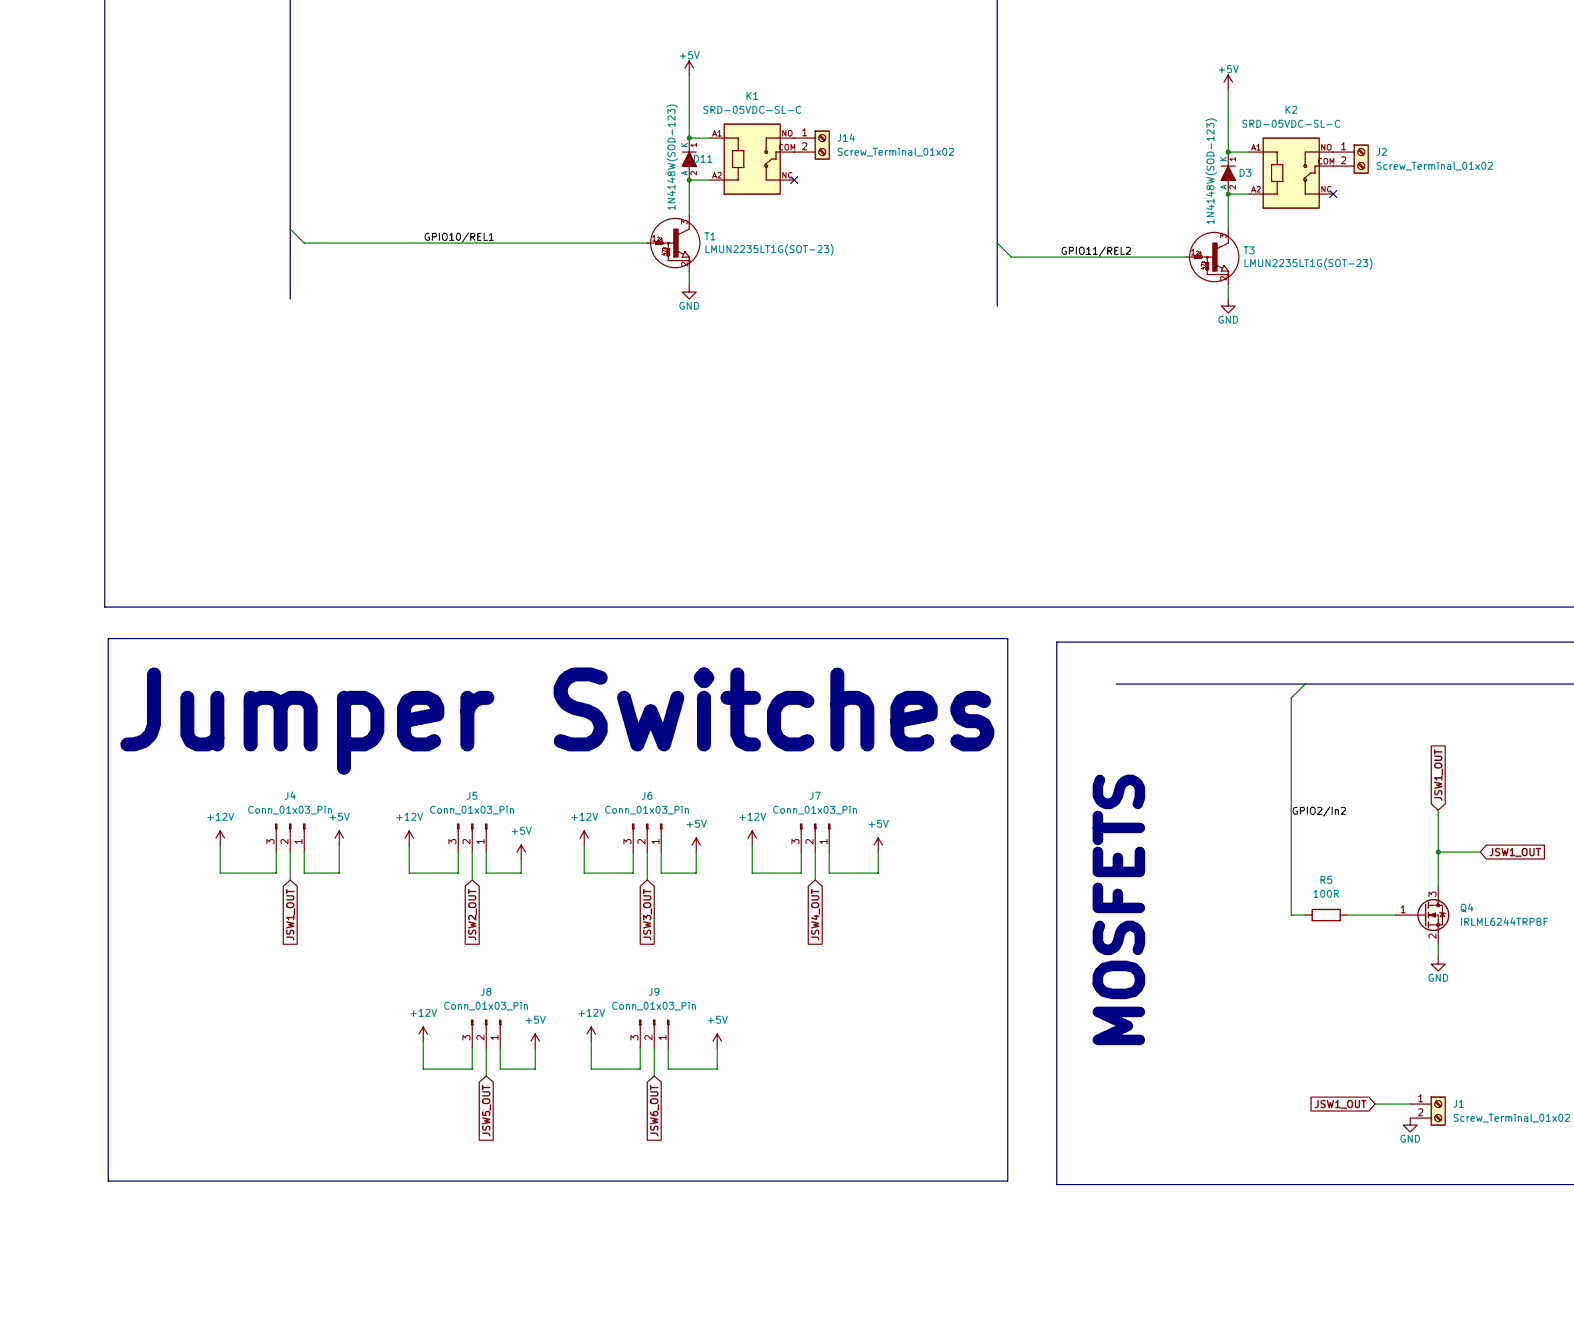
[picture p28: schematic CustmESPController.kicad_sch, part in row 2, column 1]

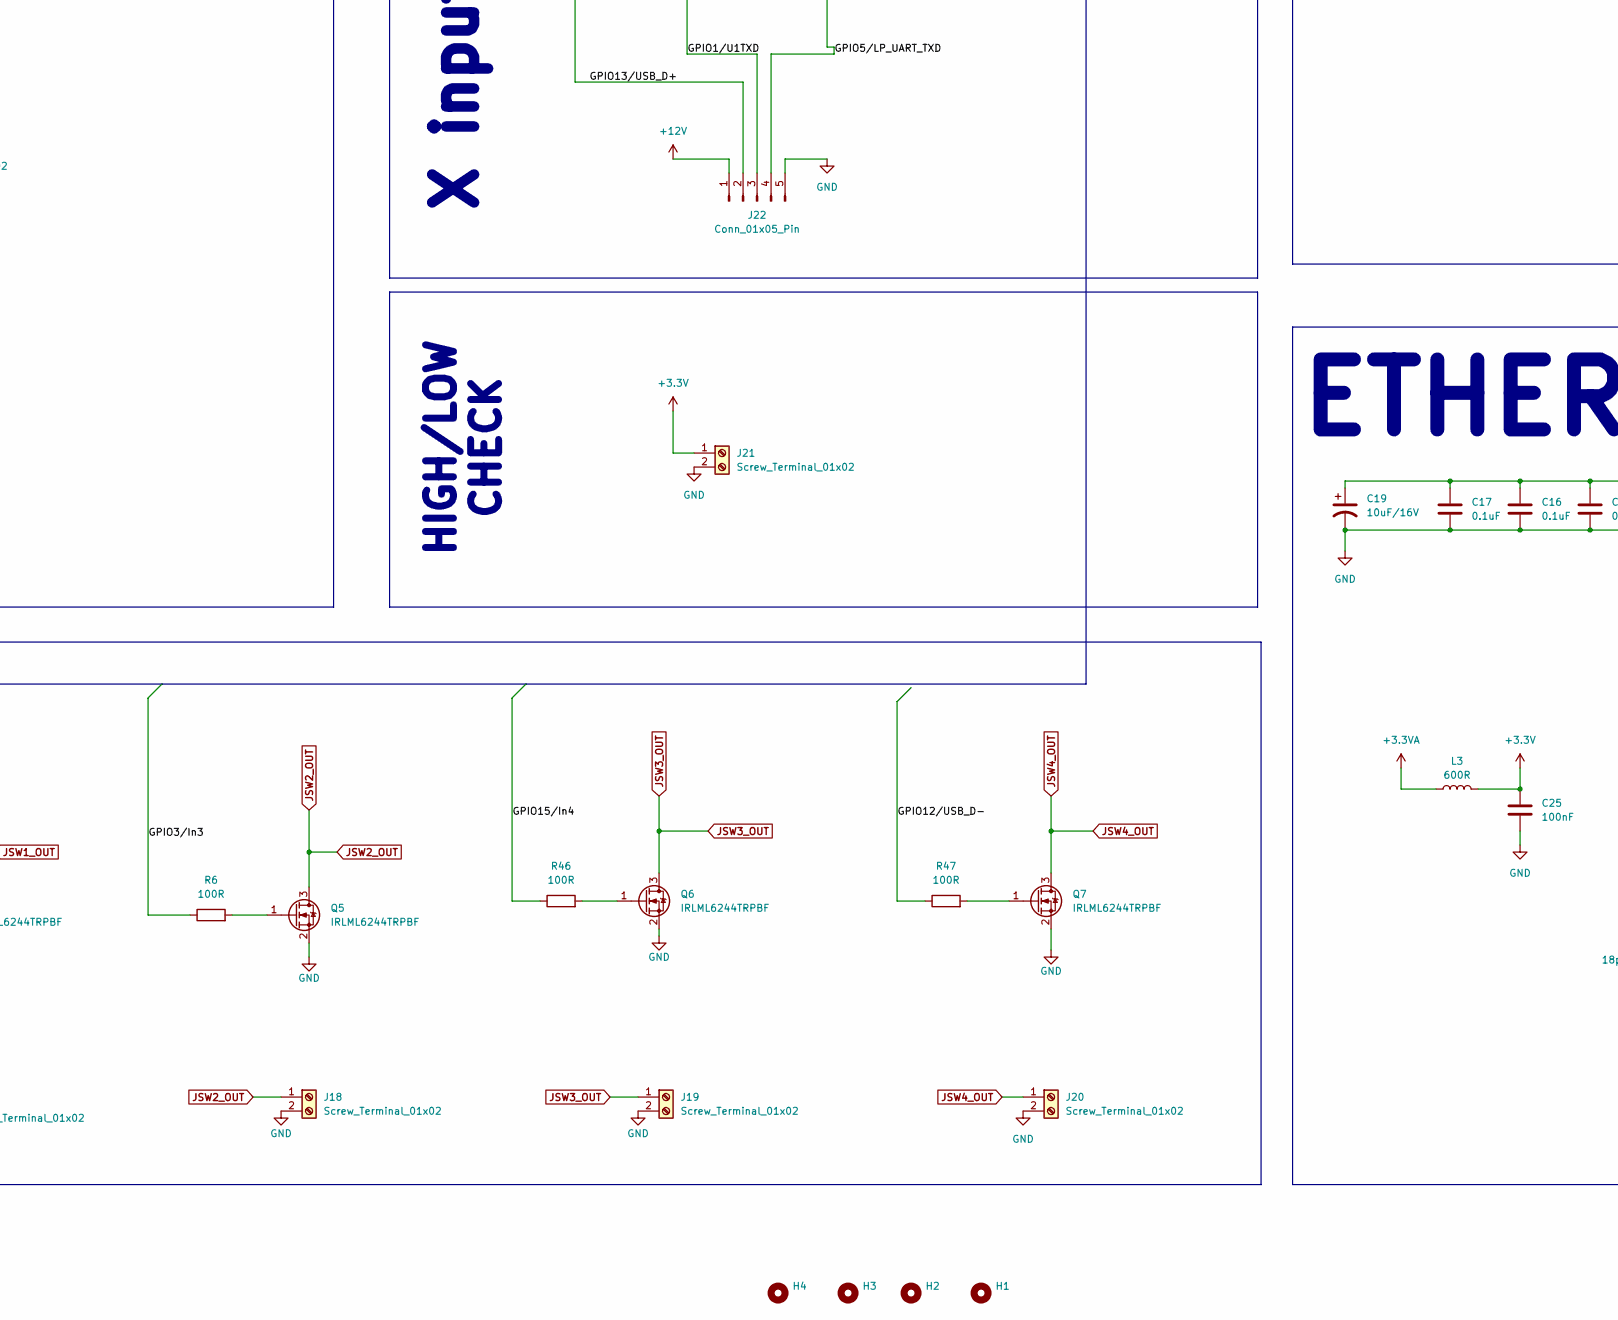
[picture p29: schematic CustmESPController.kicad_sch, part in row 2, column 2]

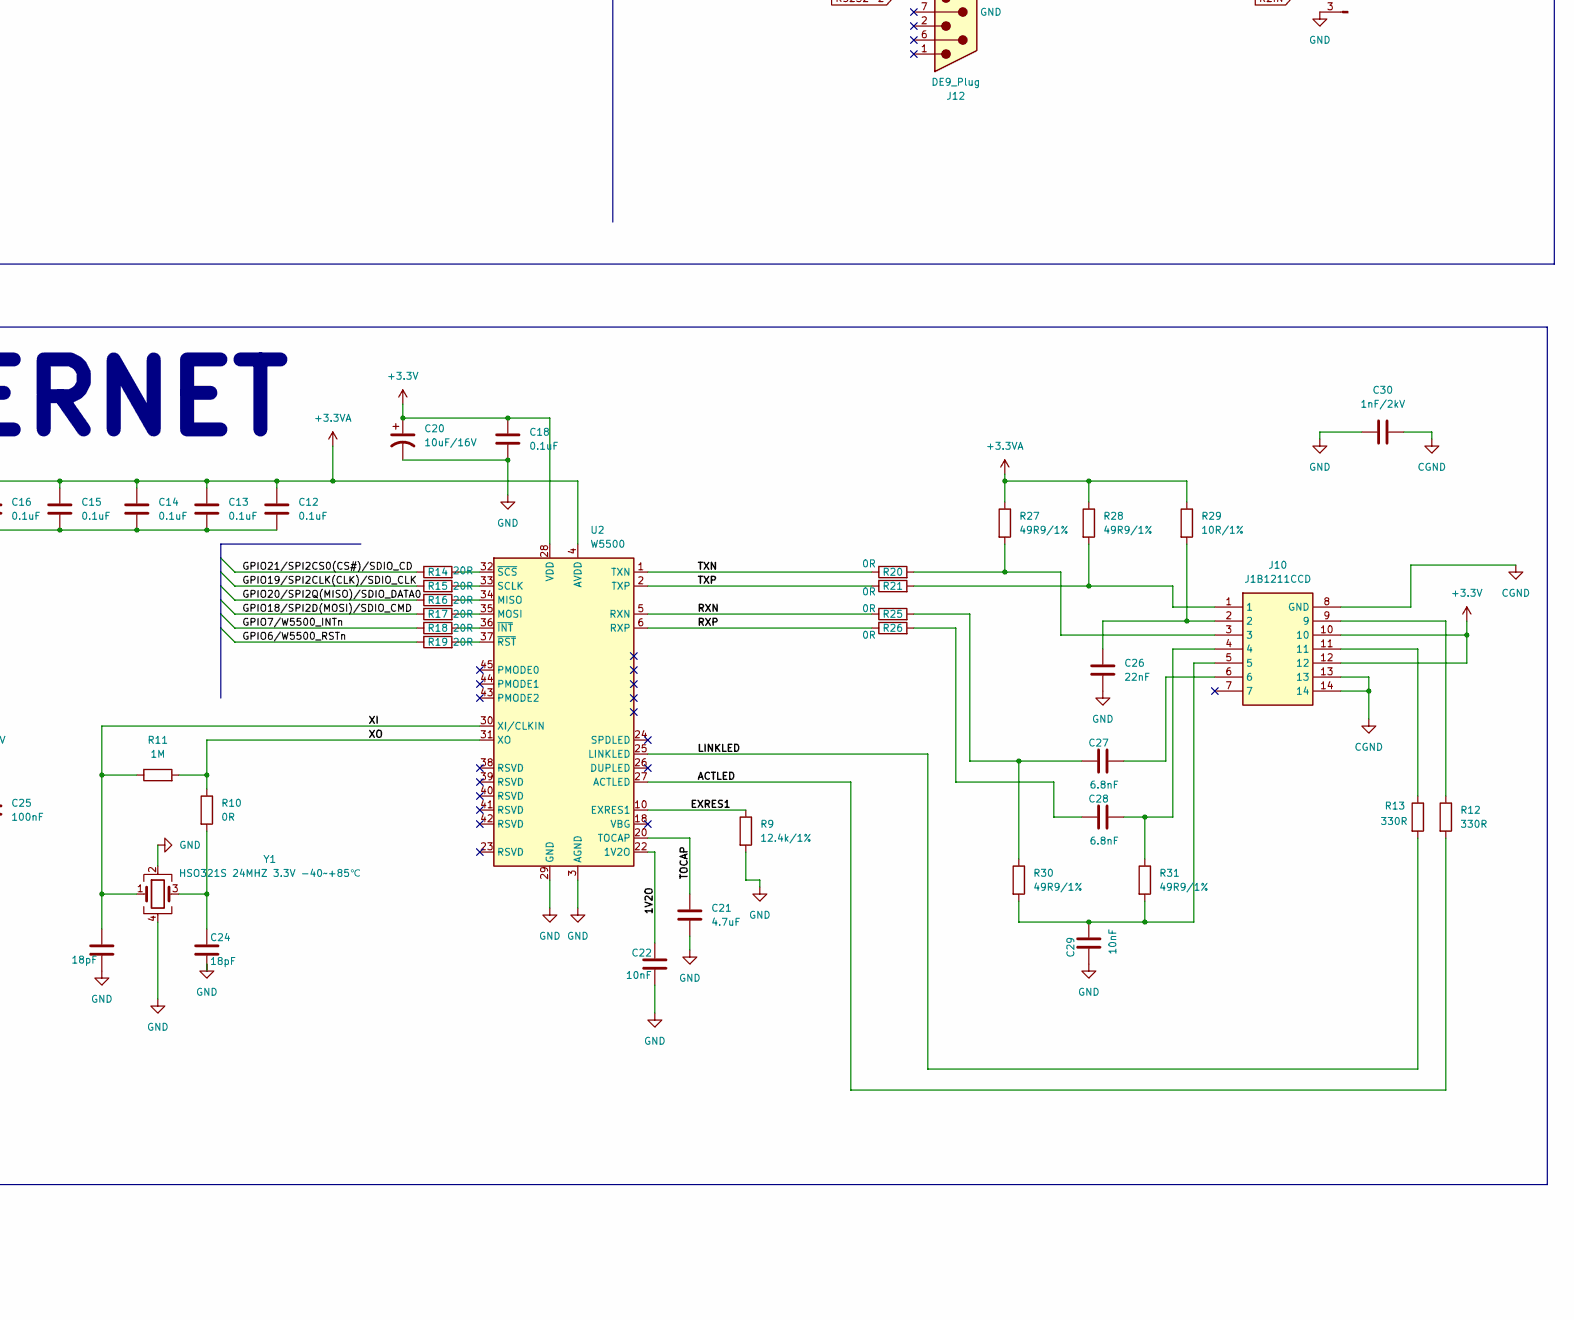
[picture p30: schematic CustmESPController.kicad_sch, part in row 2, column 3]

Parts:
C1, C7, C8, C10: 22uF/6.3V/20%/X5R/C0603; C_0603_1608Metric
C2: 100uF/100V/10%/X7R/C0603; C_0603_1608Metric
C3: 100nf/100V/10%/X7R/C0603; C_0603_1608Metric
C4: 12pF/50V/5%/COG/C0402; C_0402_1005Metric
C5: 470uF/10V/RVT1A471M0607; CP_Elec_6.3x7.7
C6: 100uF/63V/LV101M063G105ETR; CP_Elec_10x10.5
C9: 100nF/10V/10%/X7R/C0402; C_0402_1005Metric
C11: 1uF/10V/10%/X5R/C0603; C_0603_1608Metric
C12, C13, C14, C15, C16, C17, C18: 0.1uF; C_0402_1005Metric
C19, C20: 10uF/16V; C_0603_1608Metric
C21: 4.7uF; C_0402_1005Metric
C22, C29: 10nF; C_0402_1005Metric
C23, C24: 18pF; C_0402_1005Metric
C25: 100nF; C_0402_1005Metric
C26: 22nF; C_0402_1005Metric
C27, C28: 6.8nF; C_0402_1005Metric
C30: 1nF/2kV; C_0402_1005Metric
C35: 4.7uF/6.3V (10%); C_0603_1608Metric
C36: 0.1uF/50V (10%); C_0603_1608Metric
C37, C38, C39, C40, C41: 100nF; C_0603_1608Metric
D1: LED/RED/0603; LED_0603_1608Metric
D2, D9, D10: LESD5D5.0CT1G; LESD5D5.0CT1G_DTVS
D3, D11: 1N4148W(SOD-123); 1N4148W_SODFL3816X120N
D4: SMAJ58A; SMAJ58A_DIOM5026X229N
D5: SS310; DIO_SS310
D6: 1N5822; 1N5822_DIOAD3070W130L950D530
D8: LED_ARGB; LED_D5.0mm-4_RGB
H1, H2, H3, H4: MountingHole_2.2mm_M2
IC1: SMD_IC_SY8089AAAC; SY80B9AAAC_SOT95P285X140-5N; Mouser Part Number 909-SMDICSY8089AAAC
IC2: ESP32-C6-WROOM-1-N4; ESP32C6WROOM1N4; Mouser Part Number 356-ESP32C6WROOM1N4
IC3: MAX3232EIDR; MAX3232EIDR_SOIC127P600X175-16N; Mouser Part Number 595-MAX3232EIDR
J1, J2, J3, J14, J18, J19, J20, J21: Screw_Terminal_01x02; TerminalBlock_Altech_AK300-2_P5.00mm
J4, J5, J6, J7, J8, J9: Conn_01x03_Pin; PinHeader_1x03_P2.54mm_Vertical
J10: J1B1211CCD; Mouser Part Number 950-J1B1211CCD
J11, J12: DE9_Plug; DSUB-9_Female_Vertical_P2.77x2.84mm_MountingHoles
J15, J16: Conn_01x03_Pin; JST_EH_B3B-EH-A_1x03_P2.50mm_Vertical
J17: USB_C_Receptacle_USB2.0_16P; USB_C_Receptacle_HRO_TYPE-C-31-M-12
J22: Conn_01x05_Pin; JST_EH_B5B-EH-A_1x05_P2.50mm_Vertical
J23: 694106301002; 694106301002_1; Mouser Part Number 710-694106301002
K1, K2: SRD-05VDC-SL-C; RELAY_SRD-05VDC-SL-C
L1: 33uH/SL0630-330M; SL0630-330M
L2: 2.2uH/1.5A/DCR=72mR/20%/3.00x3.00x1.50mm/CD32(NR3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; IND_NR3015T2R2M
L3: 600R; L_0603_1608Metric
Q1: WPM2015-3/TR; WPM2015-3TR_SOT95P240X130-3N
Q2, Q3: SS8050-G(RANGE:120-200); SS8050_SOT95P240X115-3N
Q4, Q5, Q6, Q7: IRLML6244TRPBF; IRLML6244TRPBF_SOT95P237X112-3N
R1: 30.1k/1%/R0402; R_0402_1005Metric
R2: 5.23k/1%/R0402; R_0402_1005Metric
R3: 2.2k/R0402; R_0402_1005Metric
R4: 220k/R0402; R_0402_1005Metric
R5, R6, R46, R47: 100R; R_0402_1005Metric
R7: 10k/R0402; R_0402_1005Metric
R8: 100R/R0402; R_0402_1005Metric
R9: 12.4k/1%; R_0402_1005Metric
R10, R20, R21, R25, R26: 0R; R_0402_1005Metric
R11: 1M; R_0402_1005Metric
R12, R13: 330R; R_0402_1005Metric
R14, R15, R16, R17, R18, R19: 20R; R_0402_1005Metric
R22: 0.03R/1%/R1206; R_1206_3216Metric
R23: 4.7R/R0402; R_0402_1005Metric
R24: 49.9k/1%/R0402; R_0402_1005Metric
R27, R28, R30, R31: 49R9/1%; R_0402_1005Metric
R29: 10R/1%; R_0402_1005Metric
R32, R33: 5.1k 0603; R_0603_1608Metric
R34: 22.1k (5%); R_0603_1608Metric
R37: 100R; R_0603_1608Metric
R38, R39: 150R; R_0603_1608Metric
R40: 47.5k (5%); R_0603_1608Metric
R41: 2k (5%); R_0603_1608Metric
R42, R43: 10k (5%); R_0603_1608Metric
R44, R45: 0R (5%); R_0603_1608Metric
R48, R49: 10k; R_0402_1005Metric
SW1, SW2: TS665CJ; SW_PUSH_6mm
T1, T3: LMUN2235LT1G(SOT-23); LMUN2235LT1G
TX4138(ESOIC-8)1: TX4138_SOIC127P600X165-9N
U2: W5500; W5500_QFP50P900X900X160-48N
U3: CP2102N-Axx-xQFN28; CP2102N_QFN50P500X500X80-29N-D
Y1: HSO321S 24MHZ 3.3V -40~+85℃; HSO321S

Connections:
+3.3V: C7.1, C8.1, C9.2, C10.2, C18.1, C20.1, C25.1, C35.2, C36.2, C37.1, D8.1 (A), IC2.2 (3V3), IC3.16 (VCC), J10.10, J10.12, J21.1, L2.2, L3.2, R4.2, R7.1, U2.28 (VDD), U3.6 (VDD), U3.7 (VREGIN)
+3.3VA: C12.1, C13.1, C14.1, C15.1, C16.1, C17.1, C19.1, L3.1, R27.1, R28.1, R29.1, U2.4 (AVDD), U2.8 (AVDD), U2.11 (AVDD), U2.15 (AVDD), U2.17 (AVDD), U2.21 (AVDD)
+5V: C1.1, D3.1 (K), D6.1 (K), D11.1 (K), IC1.1 (EN), IC1.4 (IN), J4.1, J5.1, J6.1, J7.1, J8.1, J9.1, K1.A1, K2.A1, Q1.3 (S), R3.1
+5V_EXT: C4.1, C5.1, D6.2 (A), L1.2, Q1.2 (G), R1.1
+5V_USB: D9.2 (A2), J17.A4 (VBUS), J17.A9 (VBUS), J17.B4 (VBUS), J17.B9 (VBUS), Q1.1 (D), R34.1
+12V: C2.1, C6.1, D4.1 (A1), J3.1, J4.3, J5.3, J6.3, J7.3, J8.3, J9.3, J22.1, J23.1 (POWER), R22.2, TX4138(ESOIC-8)1.3 (VIN); also elsewhere on the board
/1V2O: C22.1, U2.22 (1V2O)
/ACTLED: R12.2, U2.27 (ACTLED)
/ESP_EN: C11.1, IC2.3 (EN), Q2.1 (C), R7.2, SW1.1
/EXRES1: R9.1, U2.10 (EXRES1)
/GPIO0/U1RXD: IC2.8 (IO0), IC3.9 (ROUT2)
/GPIO1/U1TXD: IC2.9 (IO1), J22.3
/GPIO2/In2: IC2.27 (IO2), R5.1
/GPIO3/In3: IC2.26 (IO3), R6.1
/GPIO4/LP_UART_RXD: IC2.4 (IO4), IC3.12 (ROUT1)
/GPIO5/LP_UART_TXD: IC2.5 (IO5), J22.4
/GPIO6/W5500_RSTn: IC2.6 (IO6), R19.1
/GPIO7/W5500_INTn: IC2.7 (IO7), R18.1
/GPIO8/USER_LED_R: IC2.10 (IO8), R37.1
/GPIO9/BOOT_BUT: IC2.15 (IO9), R8.1
/GPIO10/REL1: IC2.11 (IO10), T1.1 (B)
/GPIO11/REL2: IC2.12 (IO11), T3.1 (B)
/GPIO12/USB_D-: IC2.13 (IO12), R47.1
/GPIO13/USB_D+: IC2.14 (IO13), J22.2
/GPIO15/In4: IC2.23 (IO15), R46.1
/GPIO16/U0TXD: IC2.25 (TXD0), R44.1
/GPIO17/U0RXD: IC2.24 (RXD0), R45.1
/GPIO18/SPI2D(MOSI)/SDIO_CMD: IC2.16 (IO18), R17.1
/GPIO19/SPI2CLK(CLK)/SDIO_CLK: IC2.17 (IO19), R15.1
/GPIO20/SPI2Q(MISO)/SDIO_DATA0: IC2.18 (IO20), R16.1
/GPIO21/SPI2CS0(CS#)/SDIO_CD: IC2.19 (IO21), R14.1
/GPIO22/USER_LED_G: IC2.20 (IO22), R38.1
/GPIO23/USER_LED_B: IC2.21 (IO23), R39.1
/ILIM: R22.1, TX4138(ESOIC-8)1.2 (ILIM), TX4138(ESOIC-8)1.9 (ILIM); also elsewhere on the board
/LINKLED: R13.2, U2.25 (LINKLED)
/RXN: R25.1, U2.5 (RXN)
/RXP: R26.1, U2.6 (RXP)
/TOCAP: C21.1, U2.20 (TOCAP)
/TXN: R20.1, U2.1 (TXN)
/TXP: R21.1, U2.2 (TXP)
/XI: C23.1, R11.1, U2.30 (XI/CLKIN), Y1.1
/XO: R10.1, R11.2, U2.31 (XO)
CGND: C30.2, J10.8 (GND), J10.13, J10.14
DTR: Q3.3 (E), R42.1, U3.28 (~DTR)
ESP_3V3: R41.2
GND: C1.2, C2.2, C5.2, C6.2, C7.2, C8.2, C9.1, C10.1, C11.2, C12.2, C13.2, C14.2, C15.2, C16.2, C17.2, C18.2, C19.2, C20.2, C21.2, C22.2, C23.2, C24.2, C25.2, C26.2, C29.1, C30.1, C35.1, C36.1, C37.2, C39.1, C41.2, D1.1 (K), D2.1 (A1), D4.2 (A2), D5.2 (A), D9.1 (A1), D10.1 (A1), IC1.2 (GND), IC2.1 (GND_1), IC2.28 (GND_2), IC2.29 (GND_3), IC2.30 (GND_4), IC2.31 (GND_5), IC2.32 (GND_6), IC2.33 (GND_7), IC2.34 (GND_8), IC2.35 (GND_9), IC2.36 (GND_10), IC2.37 (GND_11), IC3.15 (GND), J1.2, J3.2, J11.0 (GND), J11.5, J12.0 (GND), J12.5, J15.3, J16.3, J17.A1 (GND), J17.A12 (GND), J17.B1 (GND), J17.B12 (GND), J17.S1 (SHIELD), J18.2, J19.2, J20.2, J21.2, J22.5, J23.2 (GND_1), J23.3 (GND_2), Q4.2 (S), Q5.2 (S), Q6.2 (S), Q7.2 (S), R2.2, R9.2, R24.2, R32.2, R33.2, R40.2, R48.2, R49.2, SW1.2, SW2.2, T1.2 (E), T3.2 (E), TX4138(ESOIC-8)1.4 (GND), U2.3 (AGND), U2.9 (AGND), U2.14 (AGND), U2.16 (AGND), U2.19 (AGND), U2.29 (GND), U2.48 (AGND), U3.3 (GND), U3.29 (GND), Y1.2, Y1.4; also elsewhere on the board
IO0: Q3.1 (C)
JSW1_OUT: J1.1, J4.2, Q4.3 (D)
JSW2_OUT: J5.2, J18.1, Q5.3 (D)
JSW3_OUT: J6.2, J19.1, Q6.3 (D)
JSW4_OUT: J7.2, J20.1, Q7.3 (D)
JSW5_OUT: J8.2, J15.1
JSW6_OUT: J9.2, J16.1
unnamed: C3.1, R23.2
unnamed: C24.1, R10.2, Y1.3
unnamed: C26.1, J10.2, R29.2
unnamed: C27.1, R25.2, R30.1
unnamed: C27.2, J10.6
unnamed: C28.1, R26.2
unnamed: C28.2, J10.4, R31.1
unnamed: C29.2, J10.5, R30.2, R31.2
unnamed: D1.2 (A), R3.2
unnamed: D3.2 (A), K2.A2, T3.3 (C)
unnamed 63: C3.2, D5.1 (K), L1.1, TX4138(ESOIC-8)1.1 (SW); also elsewhere on the board
unnamed: D8.4 (BK), R39.2
unnamed: D8.3 (GK), R38.2
unnamed: D8.2 (RK), R37.2
unnamed: D11.2 (A), K1.A2, T1.3 (C)
unnamed: IC1.5 (FB), R4.1, R24.1
unnamed: IC1.3 (LX), L2.1
unnamed: C38.1, IC3.1 (C1+)
unnamed: C38.2, IC3.3 (C1-)
unnamed: C40.1, IC3.4 (C2+)
unnamed: C40.2, IC3.5 (C2-)
unnamed: IC3.11 (DIN1), R49.1
unnamed: IC3.10 (DIN2), R48.1
unnamed: C39.2, IC3.2 (V+)
unnamed: C41.1, IC3.6 (V-)
unnamed: J2.1, K2.NO
unnamed: J2.2, K2.COM
unnamed: J10.1, R21.2, R28.2
unnamed: J10.3, R20.2, R27.2
unnamed: J10.9, R12.1
unnamed: J10.11, R13.1
unnamed: J14.1, K1.NO
unnamed: J14.2, K1.COM
unnamed: J17.A5 (CC1), R33.1
unnamed: J17.B5 (CC2), R32.1
unnamed: Q2.2 (B), R42.2
unnamed: Q3.2 (B), R43.2
unnamed: Q4.1 (G), R5.2
unnamed: Q5.1 (G), R6.2
unnamed: Q6.1 (G), R46.2
unnamed: Q7.1 (G), R47.2
unnamed: R8.2, SW2.1
unnamed 95: R23.1, TX4138(ESOIC-8)1.8 (BS); also elsewhere on the board
unnamed 96: C4.2, R1.2, R2.1, TX4138(ESOIC-8)1.5 (FB); also elsewhere on the board
unnamed: R16.2, U2.34 (MISO)
unnamed: R17.2, U2.35 (MOSI)
unnamed: R15.2, U2.33 (SCLK)
unnamed: R18.2, U2.36 (~INT)
unnamed: R19.2, U2.37 (~RST)
unnamed: R14.2, U2.32 (~SCS)
unnamed: R34.2, R40.1, U3.8 (VBUS)
unnamed: R41.1, U3.9 (~RST)
R1IN: J15.2
R2IN: J16.2
RS232-1: IC3.13 (RIN1), J11.3
RS232-2: IC3.8 (RIN2), J12.3
RTS: Q2.3 (E), R43.1, U3.24 (~RTS)
RXD: R44.2, U3.25 (RXD)
TXD: R45.2, U3.26 (TXD)
USB_DN: D10.2 (A2), J17.A7 (D-), J17.B7 (D-), U3.5 (D-)
USB_DP: D2.2 (A2), J17.A6 (D+), J17.B6 (D+), U3.4 (D+)

Notes on the sheet:
BOOT
12Vin
USB-C
ETHERNET
+5V
Jumper Switches
HIGH/LOW CHECK
RESET
X inputs
USB-TTL
Power Supply
DC Barrel
RELAYS
+3.3V
MOSFETS
RS232
+12V
RGB LED
ESP32

Board: 2 copper layers, 143 parts (0 on the bottom side), 110 nets, no tracks yet.

Other parts of the board:
TX4138: TX4138_SOIC127P600X165-9N

Their connections:
+12V: TX4138.3 (VIN); also elsewhere on the board
/ILIM: TX4138.2 (ILIM), TX4138.9 (ILIM); also elsewhere on the board
GND: TX4138.4 (GND); also elsewhere on the board
unnamed 63: TX4138.1 (SW); also elsewhere on the board
unnamed 95: TX4138.8 (BS); also elsewhere on the board
unnamed 96: TX4138.5 (FB); also elsewhere on the board
