omarmustafa130/Custom-ESP-Controller/(commit log)

2025-05-18 Schematics done
    [CustmESPController.kicad_pcb, CustmESPController.kicad_sch, ECS-3225MVQ-400-BS-TR.stp, EDI2CAP.CFG, ESP32-C6.stp, ESP32-D0WDQ6.stp, ESP32-S3.stp, H1102NLT.stp]
2025-05-19 3D PCB done
    [1N4148W.stp, 1N5822.stp, 5-2301994-9.stp, 694106301002.stp, 694106301002_1.psm, CP2102N-A01-GQFN28.stp, CustmESPController.kicad_pcb, CustmESPController.kicad_sch]
2025-05-22 3D PCB
